Sovol3d/SOVOL-ZERO/PDF/铭牌标签说明书/0011.png

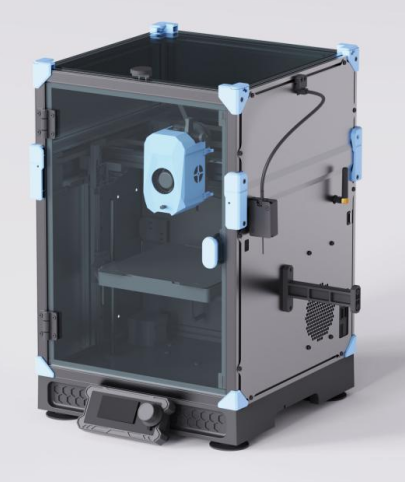
PDF/铭牌标签说明书/0011.png
