Sovol3d/SOVOL-ZERO/README.md

# Introduction

SOVOL ZERO is a fully enclosed Core-XY FDM 3D printer that ships as a complete machine. It features a build volume of 152.4x152.4x152.4mm (6x6x6 inches) and is an upgraded, large-format derivative based on the Voron V0.2 design.
It is designed to provide an alternative solution for 3D printing enthusiasts who want to use the Voron V0.2 but are hindered by its high cost and steep learning curve. We adhere to the open-source guidelines of Voron and Klipper, making SOVOL ZERO fully open-source (including hardware, firmware, and structure) for DIY enthusiasts.

Key Features of SOVOL ZERO:
Core-XY motion system design
Extremely fast operation: 1200mm/s speed and 40,000mm/s² acceleration
Generous build volume: 152.4x152.4x152.4mm (6x6x6 inches)
Stable performance: Equipped with linear guides on all axes for smooth operation
Fully assembled and pre-configured: Comes with an enclosure, ready to start printing after simple assembly
High-temperature capability: Extruder up to 350°C and bed up to 120°C, supporting a wide range of high-temp materials
Enhanced Klipper firmware details for optimized performance
No paper leveling required: Built-in inductive sensor for rapid bed leveling
Pre-installed Obico for time-lapse photography
OTA firmware updates: No need for USB drives; upgrade directly via Wi-Fi
Fully open-source design: Customize and modify to your needs
Welcome to check more on sovol3d.com

# Learn more

on Sovol Official Website: https://www.sovol3d.com/products/sovol-zero-3d-printer

# Source code

This is the official source code for SOVOL ZERO. The damage caused by modifying firmware also using the third party firmware will lose the 1 year warranty. If you need support, it’s recommended to reflash the stock firmware before contacting sovol.

Sovol doesn’t provide tech help for help users to modify source code, but if you need us to add more functions, you are welcome to send us your suggestions via Facebook Messenger or email 
info@sovol3d.com 

# Join Sovol Community

- Sovol Facebook page: https://www.facebook.com/sovol3d/
- Sovol Youtube Channel: https://www.youtube.com/c/Sovol/videos
- Sovol Offcial User Group: https://www.facebook.com/groups/sovol3d
- Sovol Forum website: https://forum.sovol3d.com/
