Sovol3d/SOVOL-ZERO/Motherboard/Extra_Pin_definition.pdf

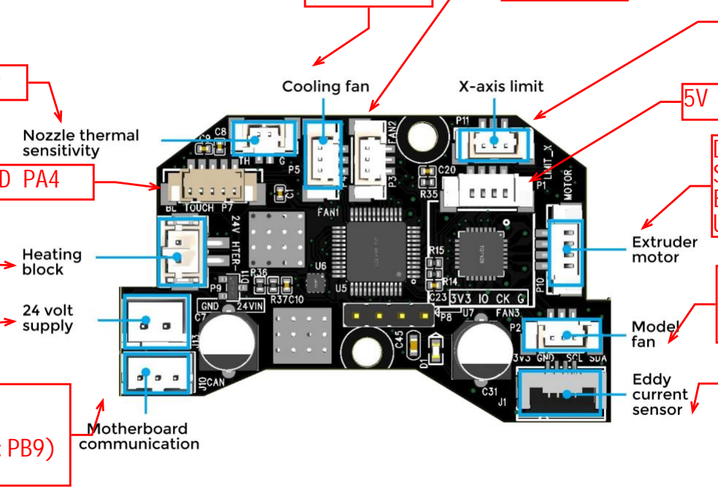
[picture p2: figure]
