Sovol3d/SOVOL-ZERO/Motherboard/Mcu_Pin_definition.pdf

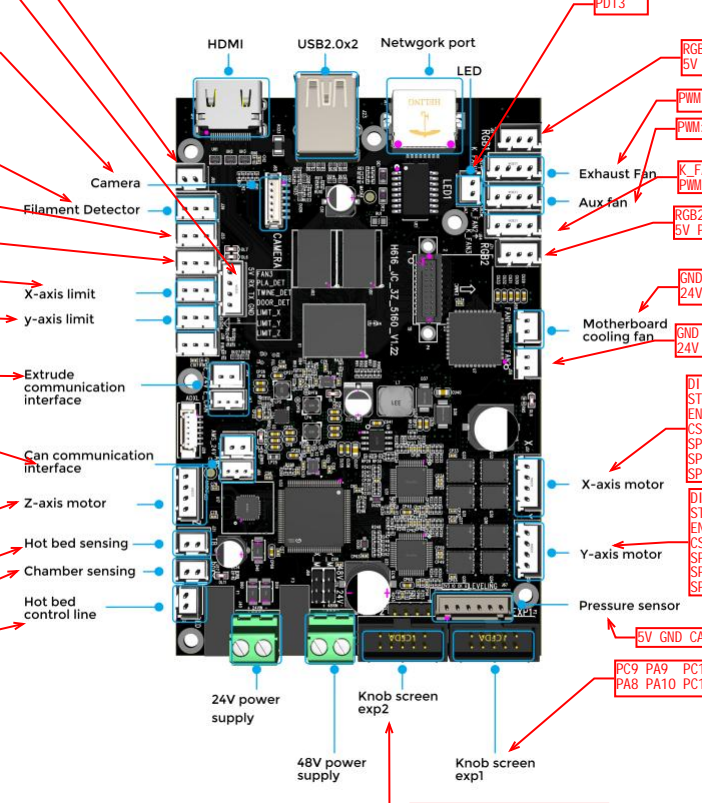
[picture p3: figure]
