Sovol3d/SOVOL-ZERO/PDF/微动开关/微动开关图纸2025.1.3.jpg

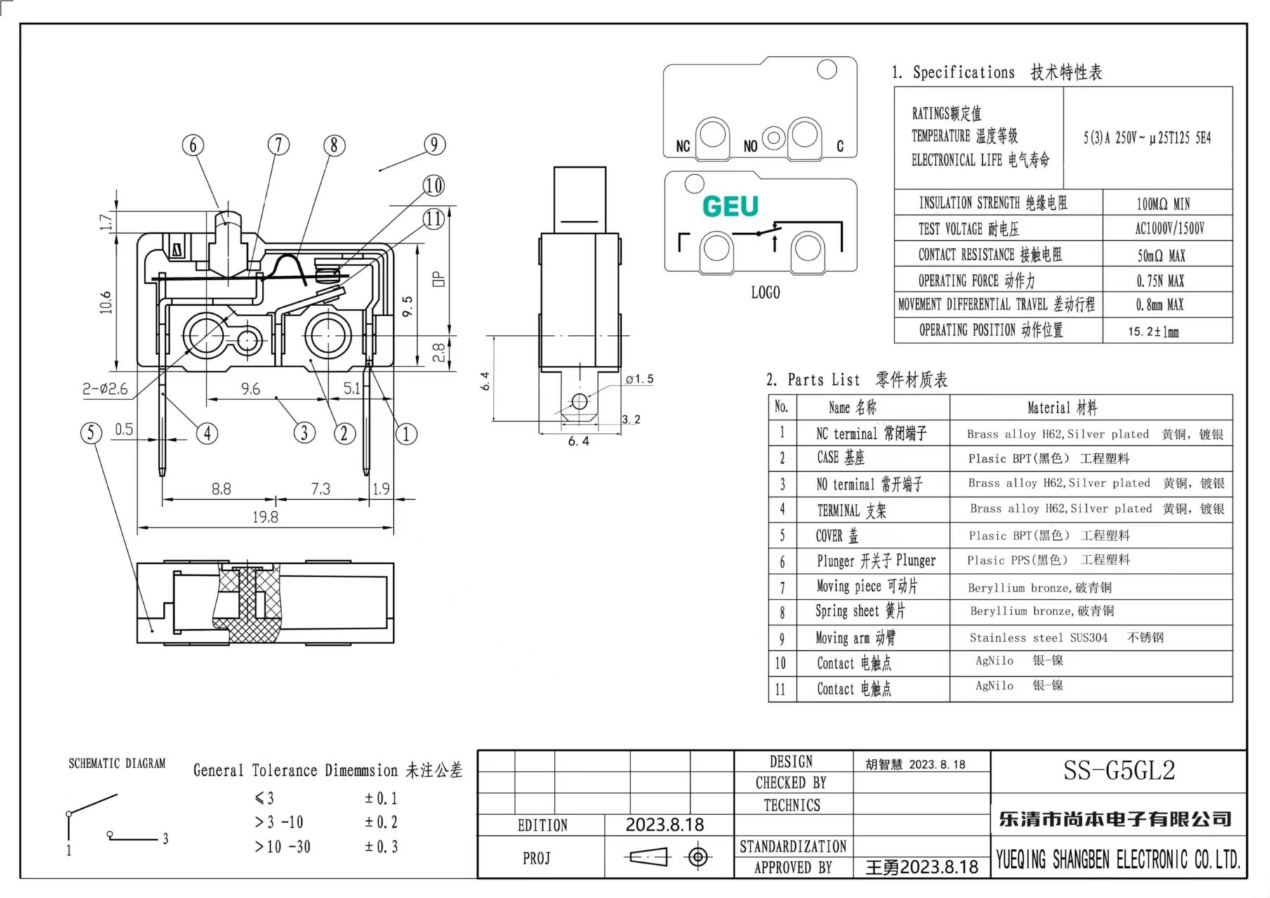
PDF/微动开关/微动开关图纸2025.1.3.jpg
