Sovol3d/SOVOL-ZERO/PDF/铭牌标签说明书/1.jpg

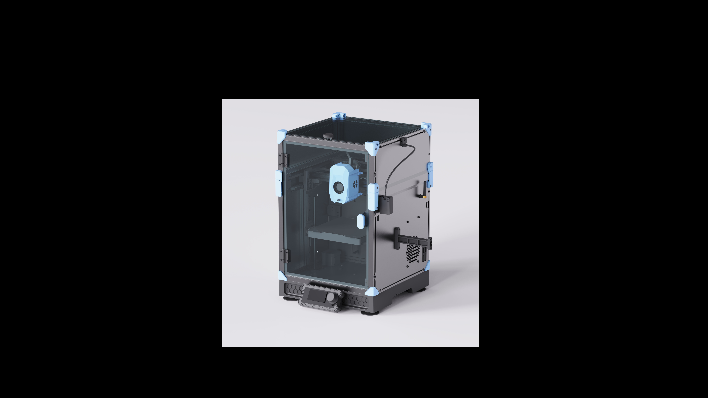
PDF/铭牌标签说明书/1.jpg
