Sovol3d/SOVOL-ZERO/PDF/PEI钢板/JXHMP4602-02014-f 打印平台钢板.step

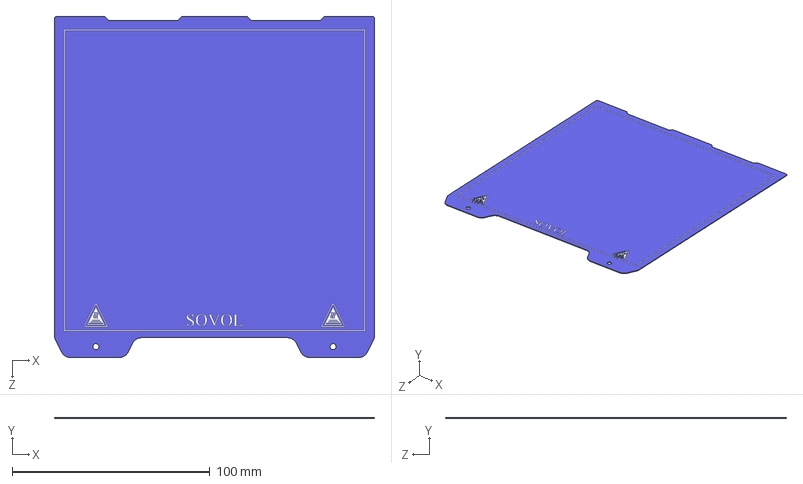
[picture p6: CAD file, 2025-03-25]
PDF/PEI钢板/JXHMP4602-02014-f 打印平台钢板.step
162.0 x 0.4 x 172.5 mm
