Sovol3d/SOVOL-ZERO/PDF/包材/泡棉/JXHMP4602-13001-h 底部泡棉.step

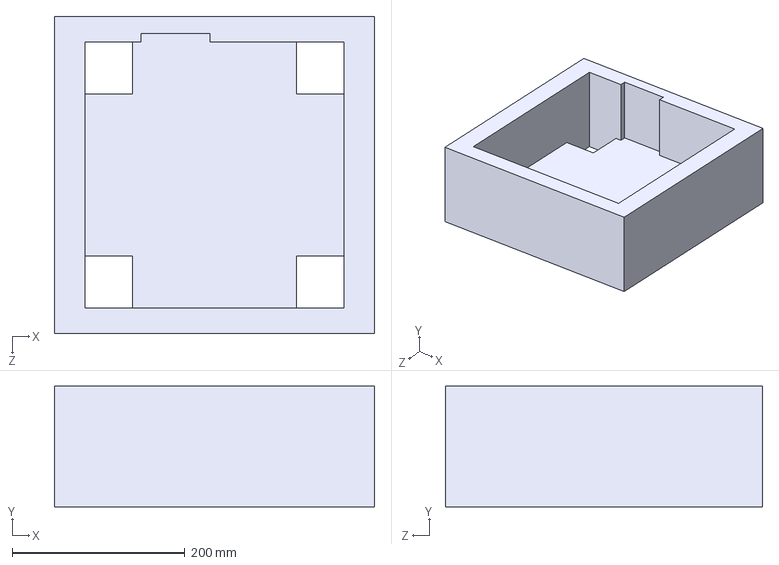
[picture p8: CAD file, 2025-03-25]
PDF/包材/泡棉/JXHMP4602-13001-h 底部泡棉.step
370.0 x 139.7 x 367.0 mm
