Sovol3d/SOVOL-ZERO/PDF/华测信/JXHMP4602-02015-f  压力传感器.step

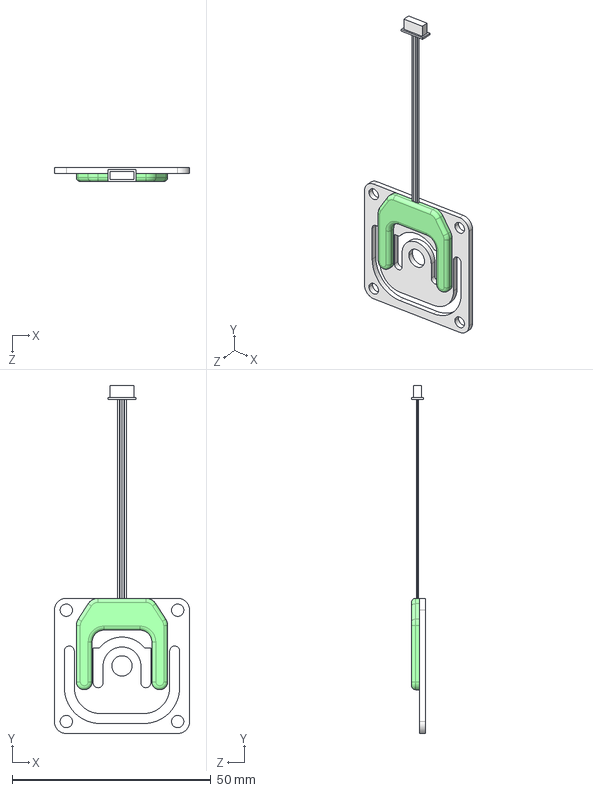
[picture p9: CAD file, 2025-03-25]
PDF/华测信/JXHMP4602-02015-f 压力传感器.step
34.0 x 87.5 x 3.50 mm
