Sovol3d/SOVOL-ZERO/PDF/开关电源盖板/JXHMP4602-04049-a 开关电源盖板.STEP

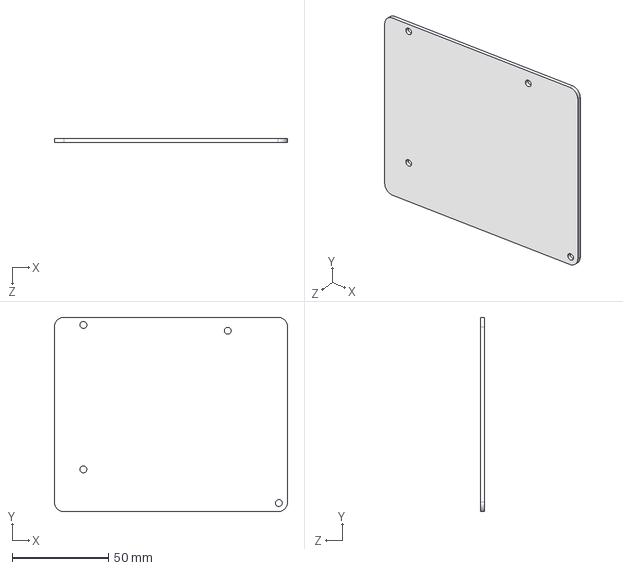
[picture p11: CAD file, 2025-03-25]
PDF/开关电源盖板/JXHMP4602-04049-a 开关电源盖板.STEP
121.0 x 101.0 x 2.00 mm
