Sovol3d/SOVOL-ZERO/PDF/电机减震垫/JXHMP4602-03091-f 电机减震垫.step

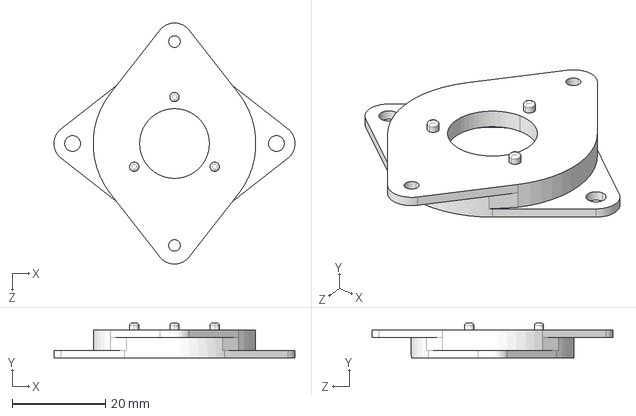
[picture p15: CAD file, 2025-03-25]
PDF/电机减震垫/JXHMP4602-03091-f 电机减震垫.step
51.8 x 7.50 x 51.8 mm
