Sovol3d/SOVOL-ZERO/PDF/硅胶套/JXHMP4602-06004-f 硅胶套.step

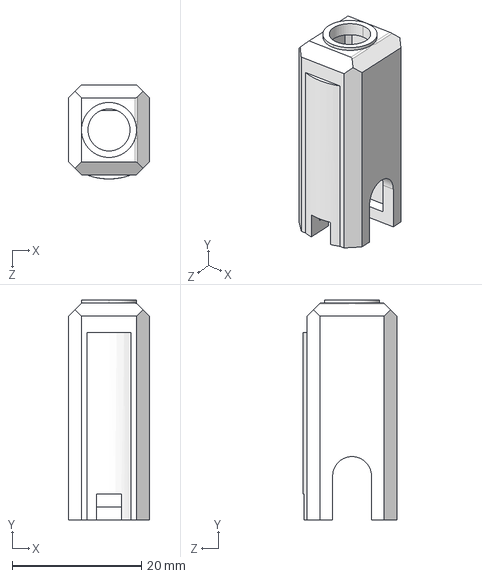
[picture p16: CAD file, 2025-03-25]
PDF/硅胶套/JXHMP4602-06004-f 硅胶套.step
12.5 x 34.0 x 14.5 mm
