Sovol3d/SOVOL-ZERO/PDF/磁铁/JXHMP4602-11081-a 磁铁.step

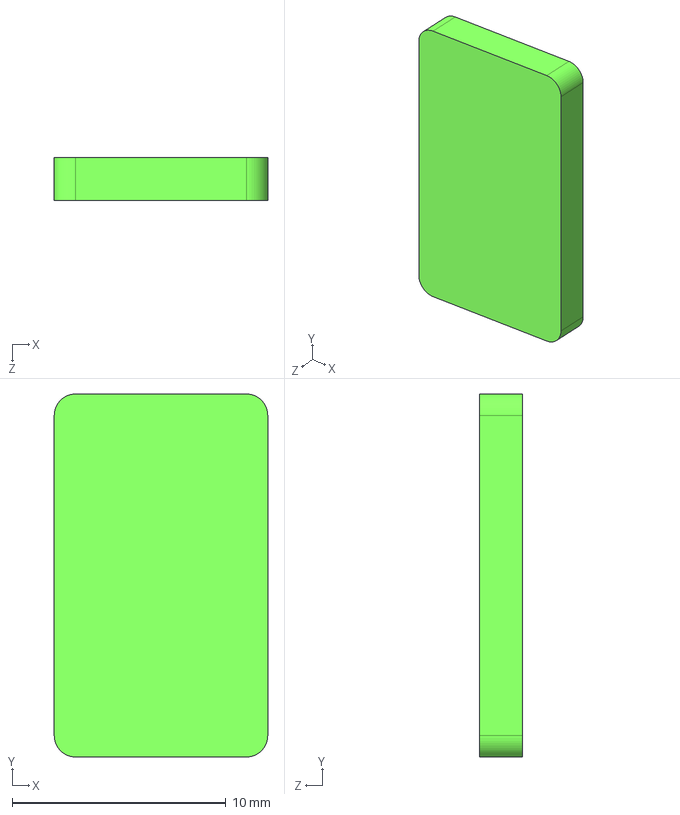
[picture p17: CAD file, 2025-03-25]
PDF/磁铁/JXHMP4602-11081-a 磁铁.step
10.0 x 17.0 x 2.00 mm
