Sovol3d/SOVOL-ZERO/PDF/线束部分/涡流FFC排线.dxf

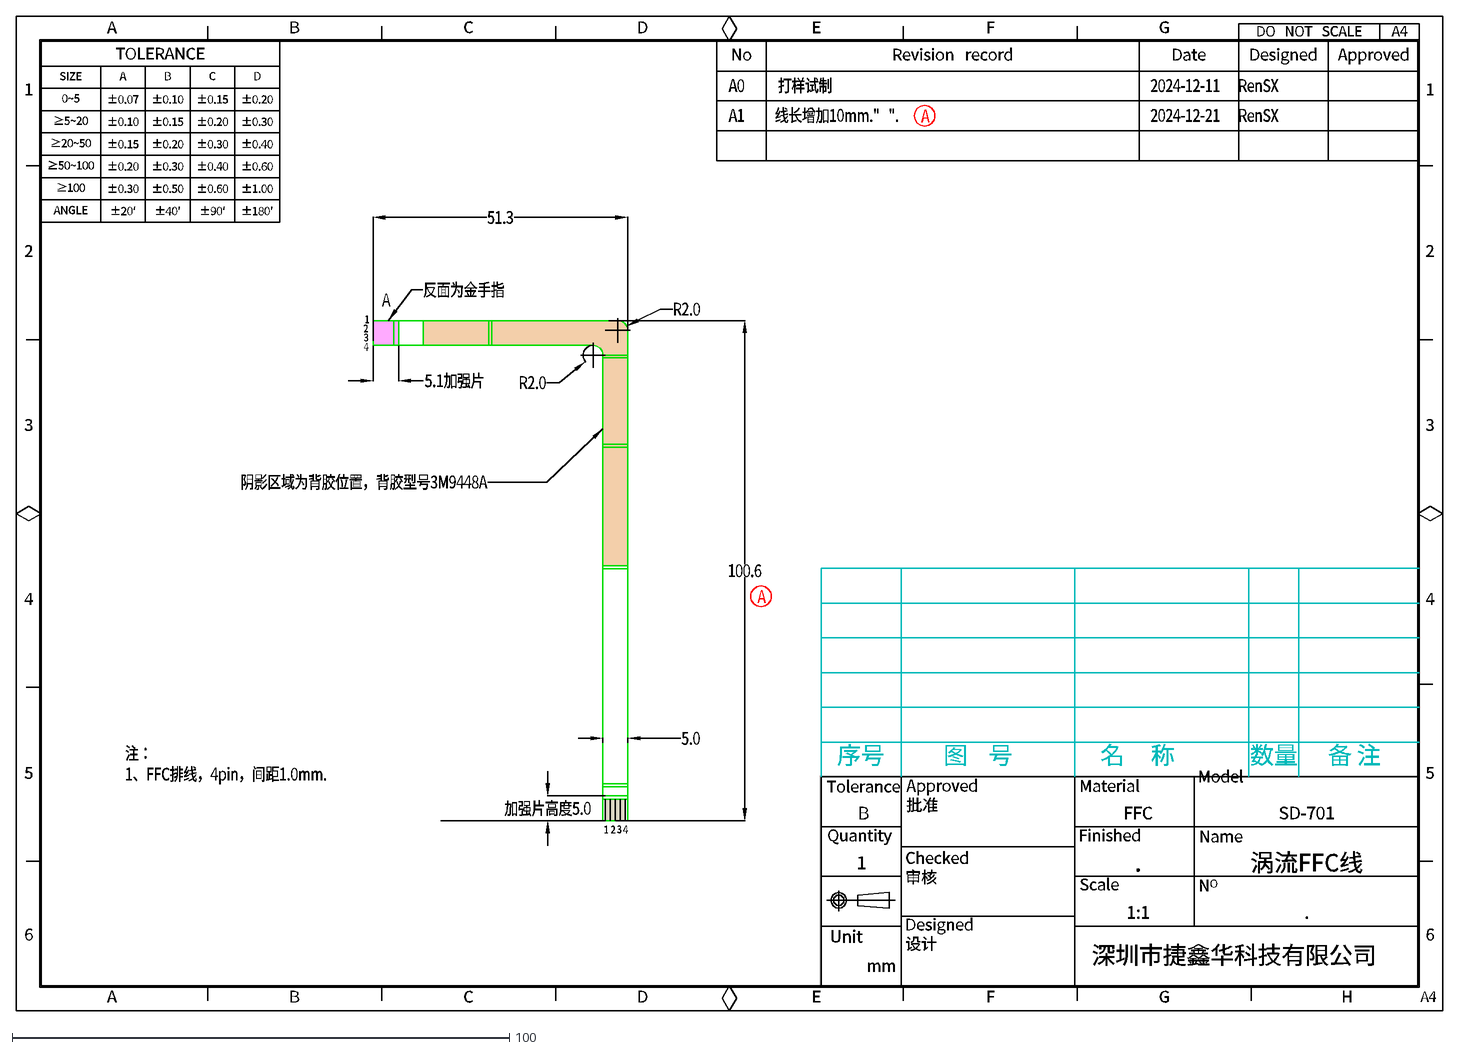
[picture p18: CAD file, 2025-03-25]
PDF/线束部分/涡流FFC排线.dxf
5.0
5.1加强片
A
1
2
3
4
反面为金手指
加强片高度5.0
SD-701
FFC
.
涡流FFC线
1:1
B
Approved
Date
Designed
Revision record
No
TOLERANCE
6
5
H
G
F
E
D
C
Tolerance
Quantity
mm
Unit
Designed 设计
Checked 审核
Scale
NO
Approved 批准
Material
Finished
Name
Model
±180′
±40′
±20′
±90′
ANGLE
≥50~100
≥100
≥20~50
0~5
SIZE
≥5~20
±0.60
±0.40
±0.30
±0.50
±0.20
±0.15
±1.00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
