Sovol3d/SOVOL-ZERO/PDF/钣金/JXHMP4602-11060-b 背面机箱封板.step

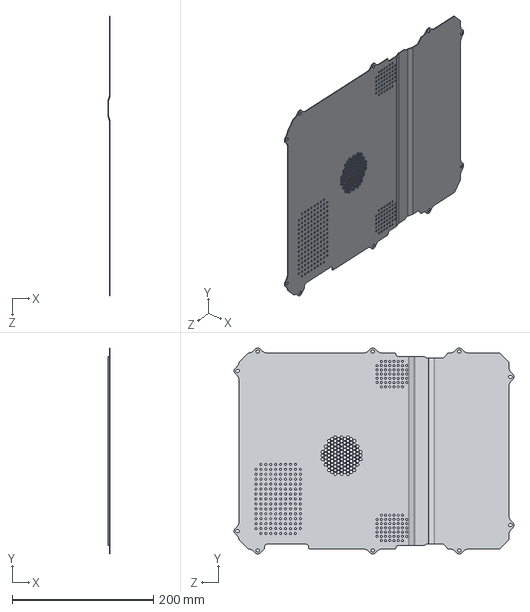
[picture p19: CAD file, 2025-03-25]
PDF/钣金/JXHMP4602-11060-b 背面机箱封板.step
3.50 x 292.0 x 396.7 mm
