Sovol3d/SOVOL-ZERO/STEP/filament runout module.step

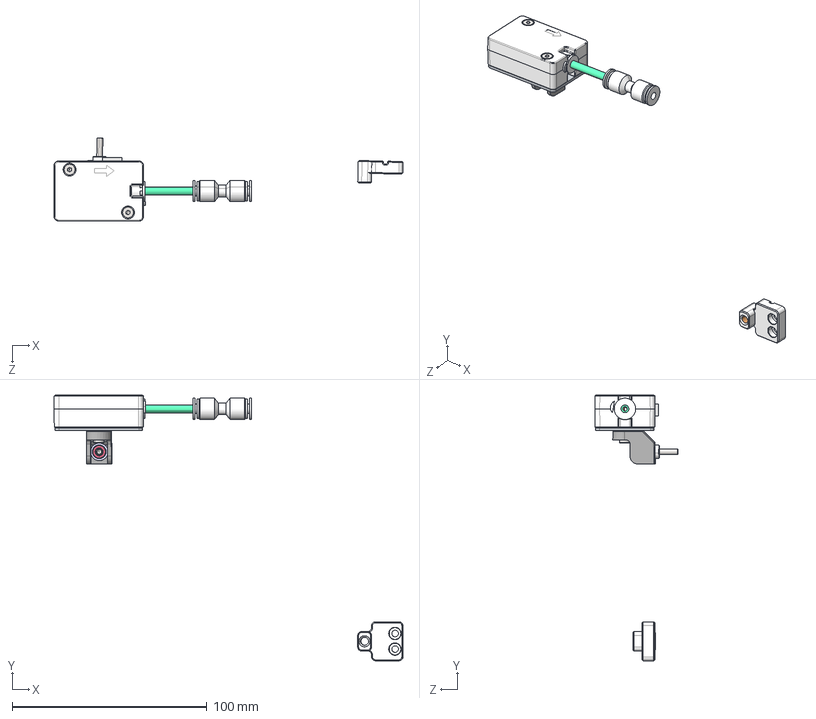
[picture p20: CAD file, 2025-03-25]
STEP/filament runout module.step
179.1 x 136.3 x 42.8 mm
JXHSV05P-07201-d 断料检测上盖 filament runout sensor top cover
JXHSV05P-07202-d 断料检测下盖 filament runout sensor below cover
JXHSV05P-07203-a 徹蹋奪1 feed tube
JXHSV05P-07204-a 徹蹋奪2 feed tube
JXHSV05P-07205-f Uﾐﾍｲﾛﾖ盖ﾐ u-groove bearing
JXHSV05P-07206-d 限位开关挡块 limit switch stop block
JXHSV05P-07208-a 粣 a-axis
JXHSV05P-07209-a 粣杶 axle sleeve
JXHSV05P-07210-h 断料检测PCB filament runout sensor pcb
JXHSV06P-07009-a 啊裝路燭翐 swing rod isolation column x 2
JXHSV05P-07214-b 嘐隅啣 fixed plate
线径0.3外径4长度10弹簧 断料检测弹簧 filament runout sensor spring
固定4mm铁氟龙管 快插接头管卡 tpfe tube quick plug adapter tube
固定4MM铁氟龙管 快接头 tpfe tube quick coupling
铁氟龙管 ptfe tube
GB-T-70.1-2000-M2X5 内六角圆柱头螺丝 hex socket cylindrical head screws x 2
GB-T-70.3-2000-M3x18 内六角沉头螺丝 hexagon socket countersunk head screw x 2
JXHSV06P-07008-d 断料检测摆杆 filament runout sensor oscillating bar
GB-T-70.1-2000-M3x8 内六角圆柱头螺丝 hex socket cylindrical head screws
A级大平垫GB-T96.1-2022-3 平垫圈 flat washer
GB-T-70.1-2000-M3x16 内六角圆柱头螺丝 hexagon socket countersunk head screw
ァ雄諉芛 pneumatic joint
JXHSV05P-07213-d 铁氟龙管支撑架 ptfe tube support frame
JXHMP4602-02018-d 路燭翐 insulated column
