Sovol3d/SOVOL-ZERO/PDF/包材/泡棉/JXHMP4602-13004-h 限位泡棉.STEP

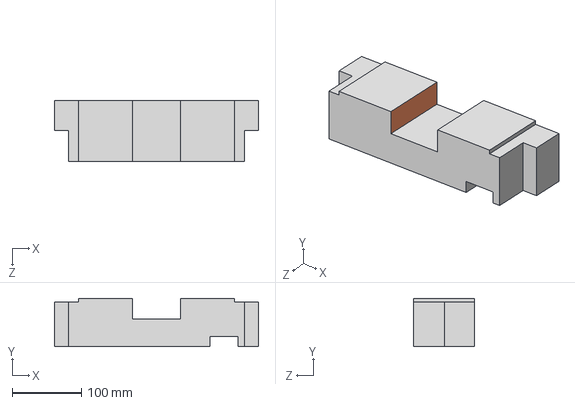
[picture p21: CAD file, 2025-03-25]
PDF/包材/泡棉/JXHMP4602-13004-h 限位泡棉.STEP
295.0 x 70.0 x 88.0 mm
