Sovol3d/SOVOL-ZERO/PDF/型材/JXHMP4602-03090-a 前右立柱.step

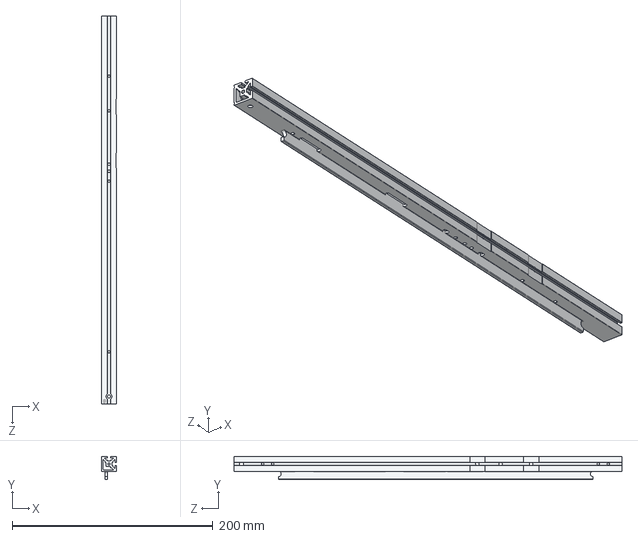
[picture p22: CAD file, 2025-03-25]
PDF/型材/JXHMP4602-03090-a 前右立柱.step
15.0 x 23.0 x 386.8 mm
