Sovol3d/SOVOL-ZERO/STEP/filament holder kit.step

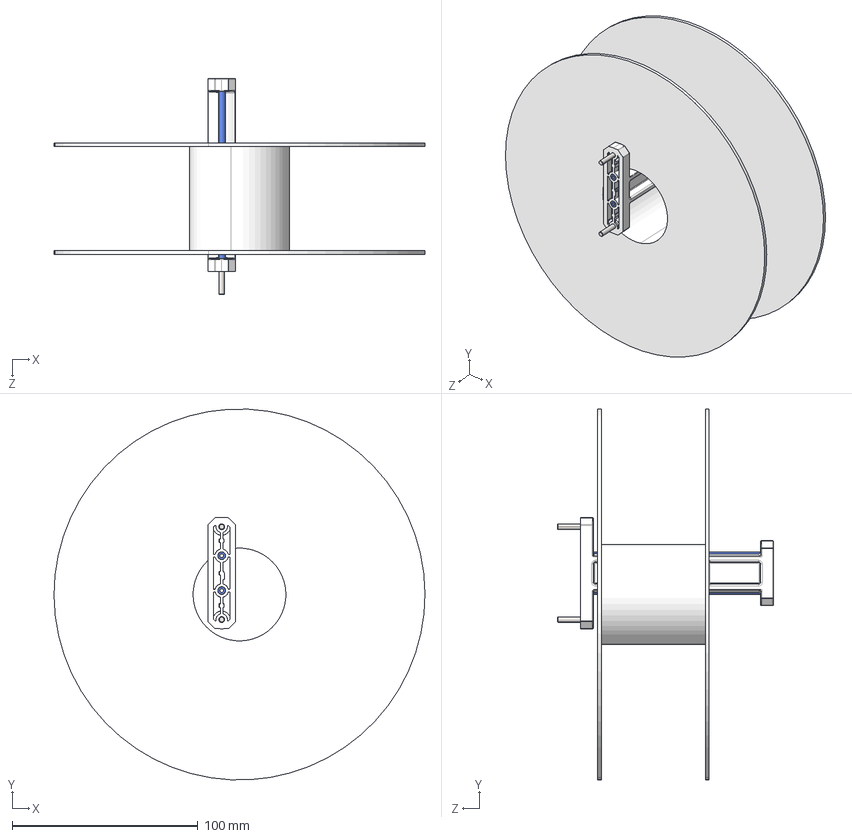
[picture p27: CAD file, 2025-03-25]
STEP/filament holder kit.step
200.0 x 199.8 x 116.4 mm
1KG瘧第 filament
JXHMP4602-10001-d 蹋殤 filament holder
外径4mm,内径2mm长度xxmm 铁氟龙管 ptfe tube x 2
GB-T-70.1-2000-M3x16 内六角圆柱头螺丝 hexagon socket countersunk head screw x 2
