Sovol3d/SOVOL-ZERO/PDF/包材/泡棉/JXHMP4602-13003-h 平盖棉.step

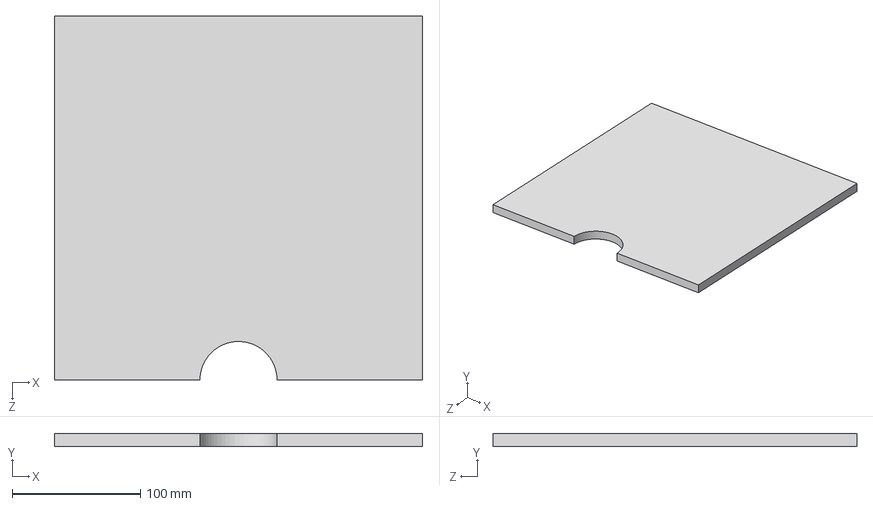
[picture p28: CAD file, 2025-03-25]
PDF/包材/泡棉/JXHMP4602-13003-h 平盖棉.step
287.0 x 10.0 x 283.5 mm
