Sovol3d/SOVOL-ZERO/PDF/型材/JXHMP4602-03023-a 底后横梁.step

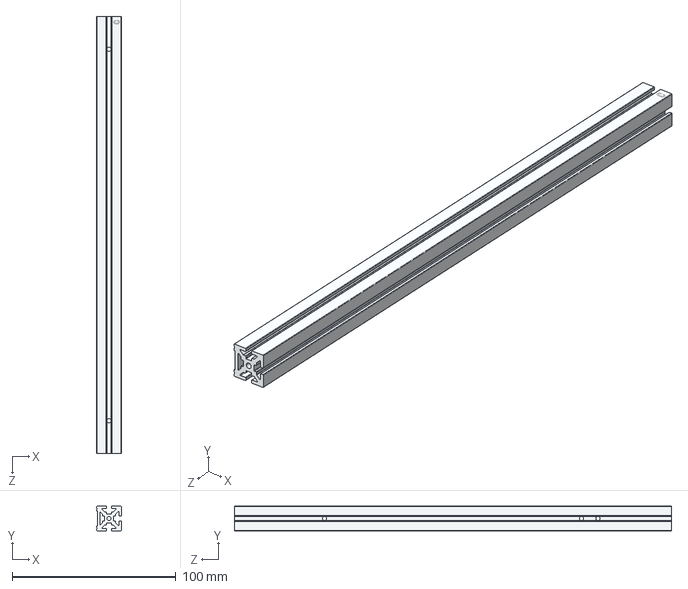
[picture p29: CAD file, 2025-03-25]
PDF/型材/JXHMP4602-03023-a 底后横梁.step
15.0 x 15.0 x 267.0 mm
