Sovol3d/SOVOL-ZERO/PDF/机加/JXHMP4602-08054-a 硬化喷嘴.STEP

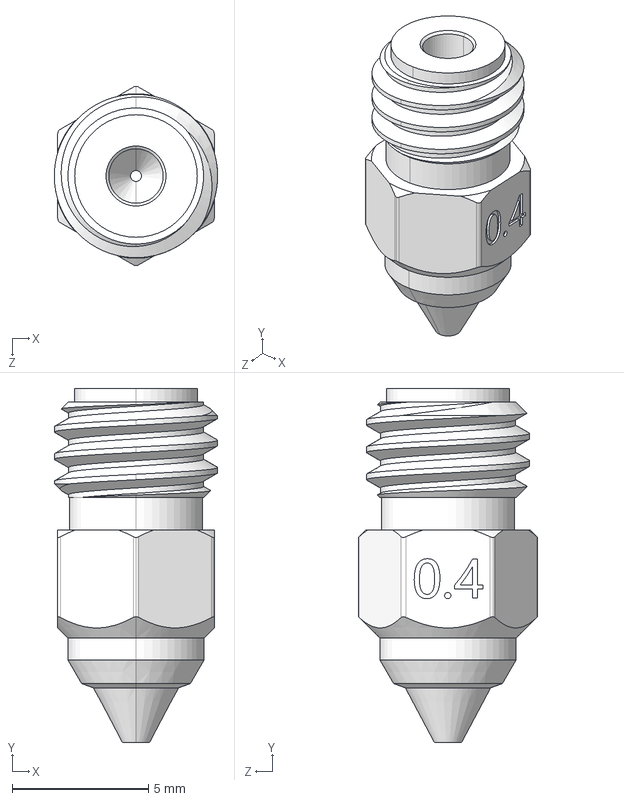
[picture p30: CAD file, 2025-03-25]
PDF/机加/JXHMP4602-08054-a 硬化喷嘴.STEP
6.00 x 13.0 x 6.58 mm
