Sovol3d/SOVOL-ZERO/PDF/滑轨/MGN9H1R197Z0 直线滑轨.step

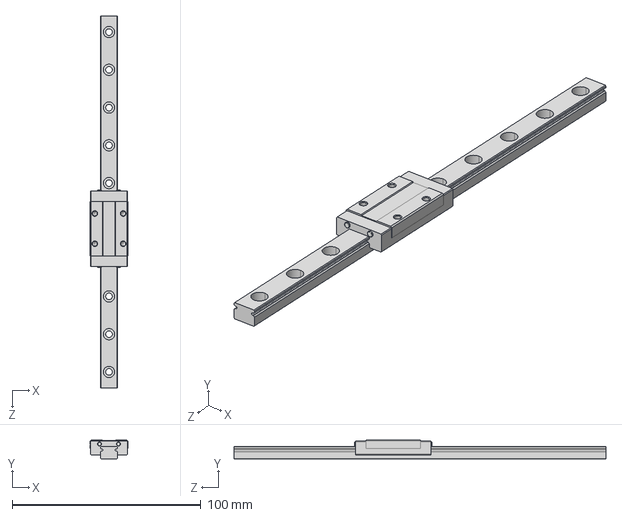
[picture p31: CAD file, 2025-03-25]
PDF/滑轨/MGN9H1R197Z0 直线滑轨.step
20.0 x 10.0 x 197.0 mm
MGNR9R197C 賑寢
MGN9HZ1C 賑輸
