Sovol3d/SOVOL-ZERO/PDF/钣金/JXHMP4602-01004-b 底座惰轮调整板.STEP

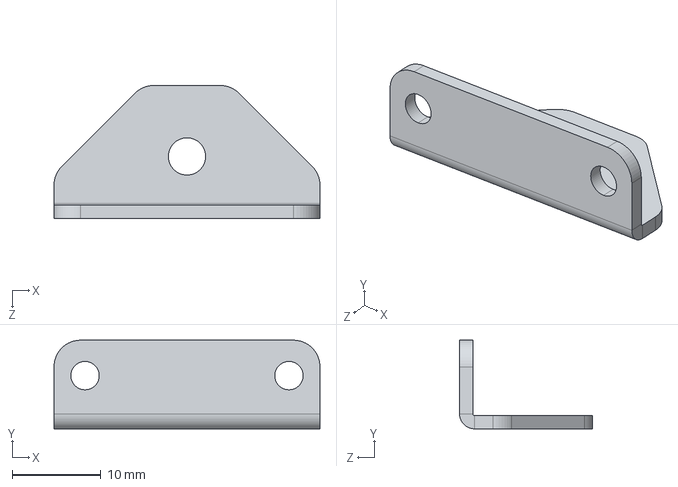
[picture p32: CAD file, 2025-03-25]
PDF/钣金/JXHMP4602-01004-b 底座惰轮调整板.STEP
30.0 x 10.0 x 15.0 mm
