Sovol3d/SOVOL-ZERO/STEP/camera module.step

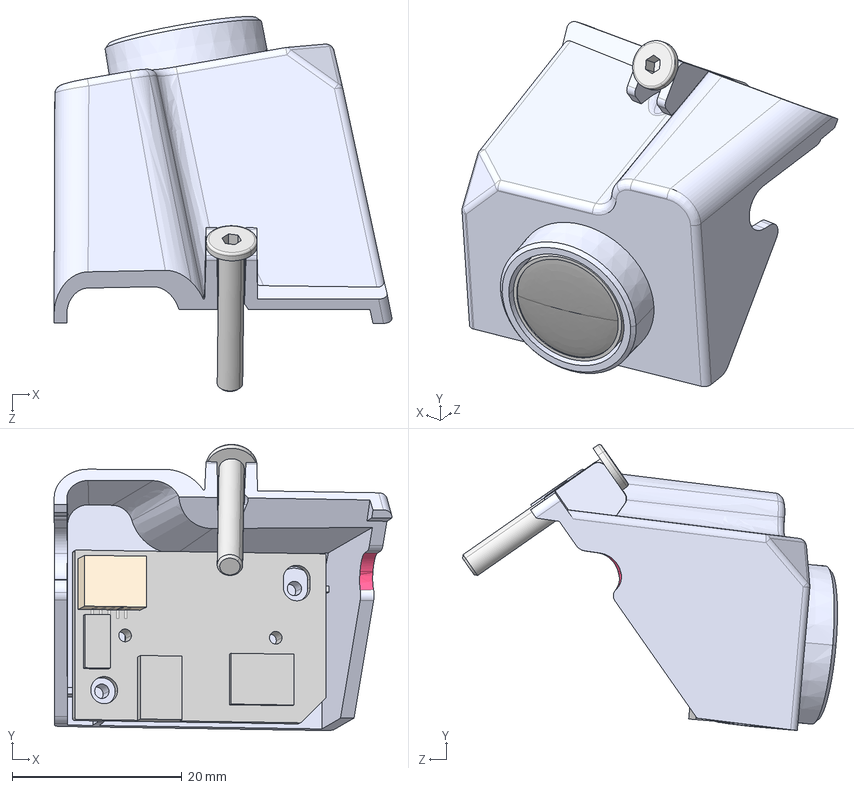
[picture p33: CAD file, 2025-03-25]
STEP/camera module.step
39.8 x 33.7 x 44.1 mm
JXHMP4602-09081-d 摄像头盖板 camera cover plate
160度广角100W像素 摄像头模组 wide angle camera module
M3X20 ｱ簇ｽﾍｷﾂﾝﾋｿ fat offset head screws
