Sovol3d/SOVOL-ZERO/PDF/包材/泡棉/JXHMP4602-13009-h 填充泡棉1.step

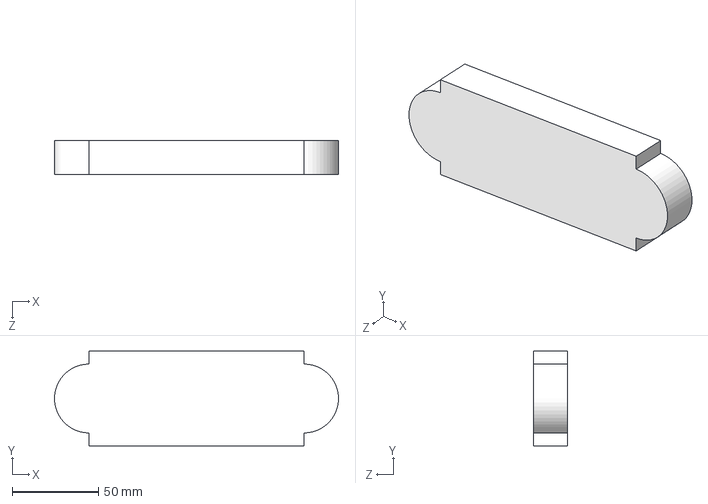
[picture p34: CAD file, 2025-03-25]
PDF/包材/泡棉/JXHMP4602-13009-h 填充泡棉1.step
165.0 x 55.0 x 20.0 mm
