Sovol3d/SOVOL-ZERO/PDF/型材/JXHMP4602-03040-a 顶前型材.step

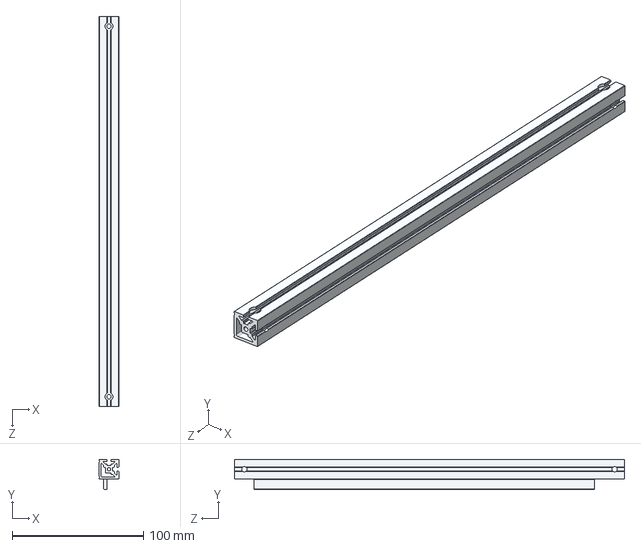
[picture p35: CAD file, 2025-03-25]
PDF/型材/JXHMP4602-03040-a 顶前型材.step
15.0 x 23.0 x 297.0 mm
