Sovol3d/SOVOL-ZERO/PDF/钣金/JXHMP4602-01008-b 底座封板.step

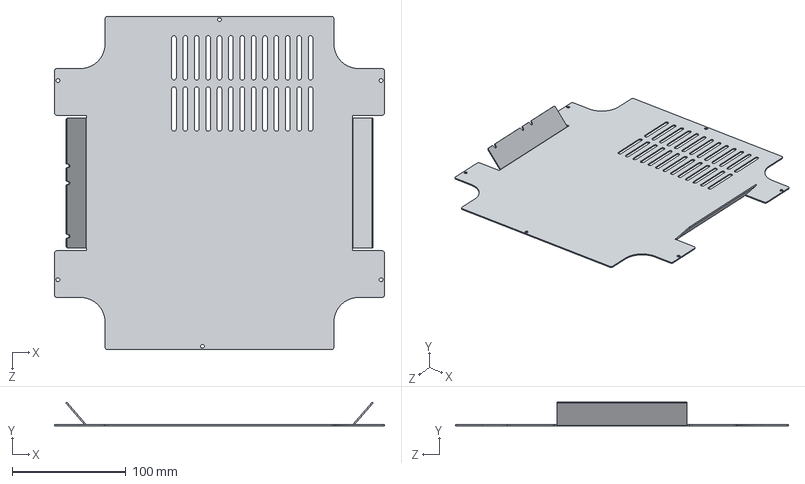
[picture p37: CAD file, 2025-03-25]
PDF/钣金/JXHMP4602-01008-b 底座封板.step
290.0 x 20.8 x 293.0 mm
