Sovol3d/SOVOL-ZERO/PDF/包材/泡棉/JXHMP4602-13002-h 顶部泡棉.step

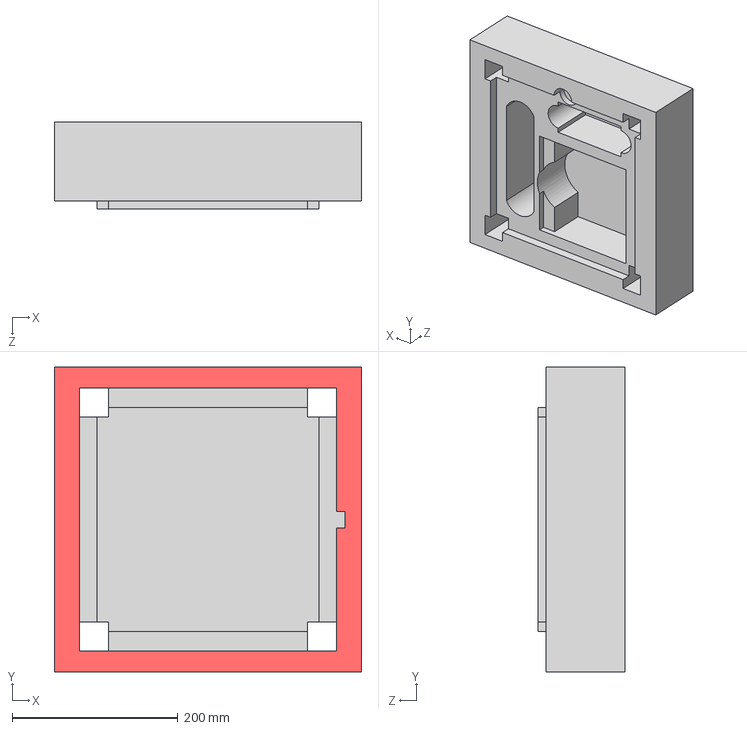
[picture p38: CAD file, 2025-03-25]
PDF/包材/泡棉/JXHMP4602-13002-h 顶部泡棉.step
370.0 x 367.0 x 105.0 mm
