Sovol3d/SOVOL-ZERO/PDF/机加/JXHMP4062-08048-a 加热块.step

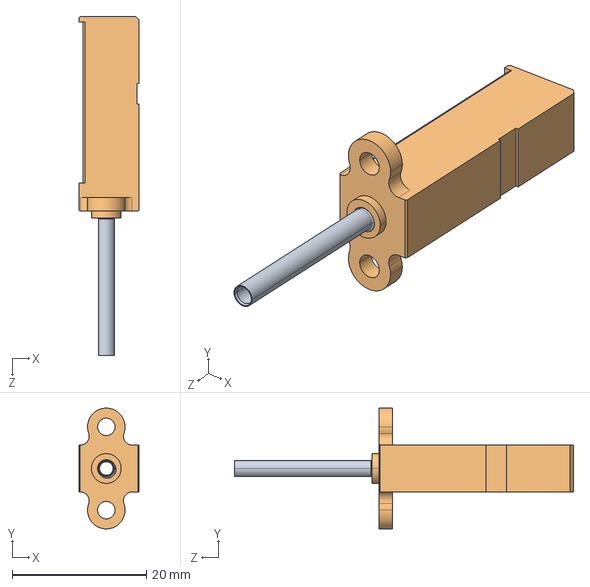
[picture p40: CAD file, 2025-03-25]
PDF/机加/JXHMP4062-08048-a 加热块.step
9.00 x 18.0 x 50.5 mm
