Sovol3d/SOVOL-ZERO/PDF/包材/泡棉/JXHMP4602-13008-h 限位块.STEP

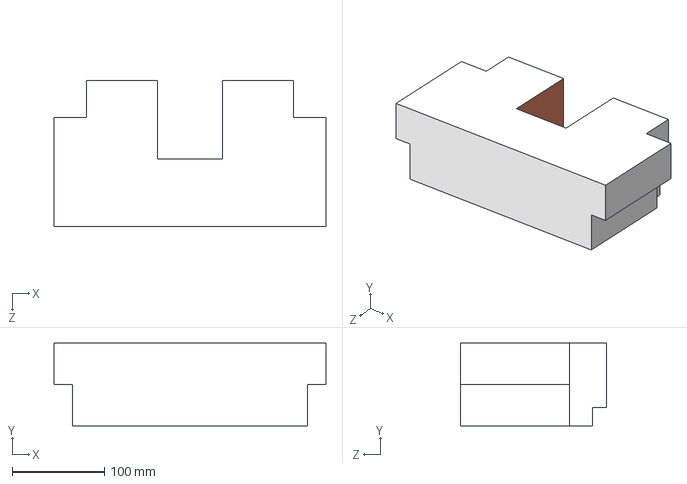
[picture p42: CAD file, 2025-03-25]
PDF/包材/泡棉/JXHMP4602-13008-h 限位块.STEP
295.0 x 90.0 x 158.0 mm
