Sovol3d/SOVOL-ZERO/PDF/型材/JXHMP4602-03019-a 后下立柱.step

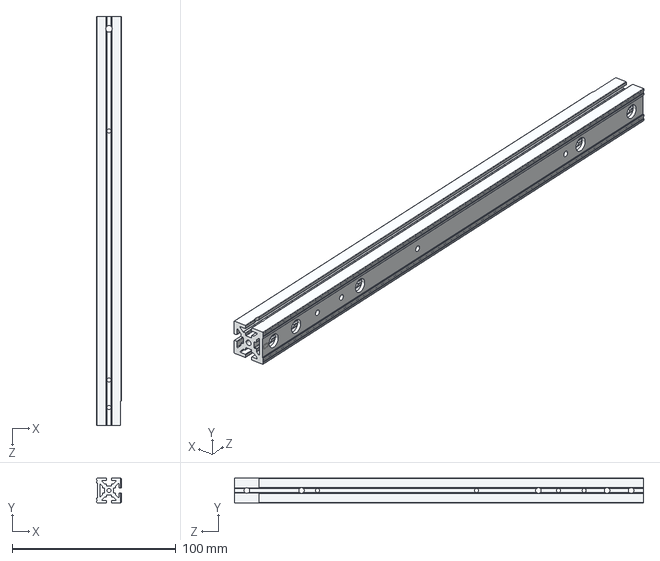
[picture p43: CAD file, 2025-03-25]
PDF/型材/JXHMP4602-03019-a 后下立柱.step
15.0 x 15.0 x 250.0 mm
