Sovol3d/SOVOL-ZERO/PDF/包材/泡棉/JXHMP4602-13010-h 填充泡棉2.step

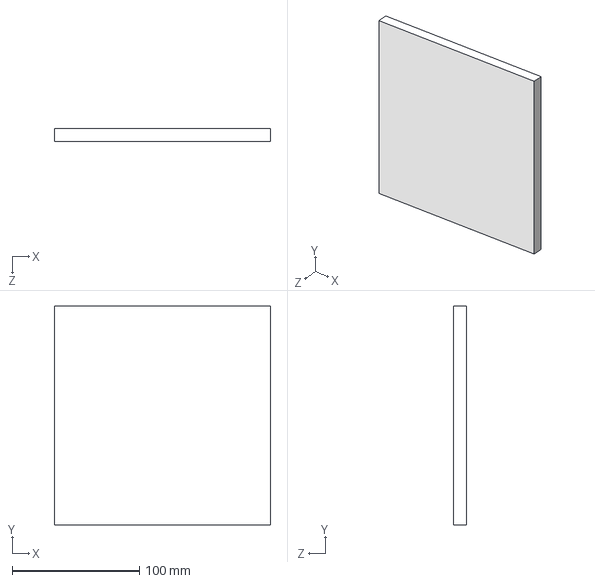
[picture p44: CAD file, 2025-03-25]
PDF/包材/泡棉/JXHMP4602-13010-h 填充泡棉2.step
170.0 x 172.0 x 10.0 mm
