Sovol3d/SOVOL-ZERO/PDF/包材/泡棉/JXHMP4602-13011-h 填充泡棉3.step

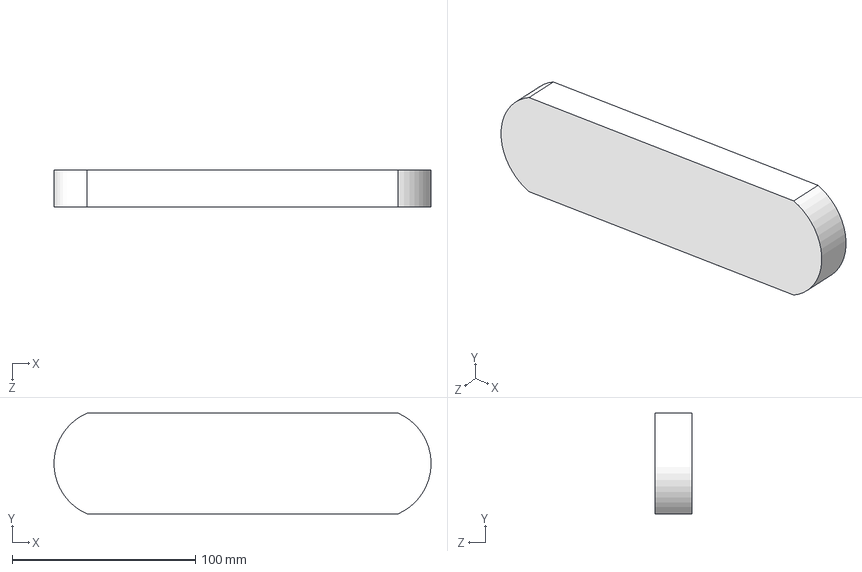
[picture p46: CAD file, 2025-03-25]
PDF/包材/泡棉/JXHMP4602-13011-h 填充泡棉3.step
206.0 x 55.0 x 20.0 mm
