Sovol3d/SOVOL-ZERO/PDF/机加/JXHMP4602-12022-a 喷头板散热片.STEP

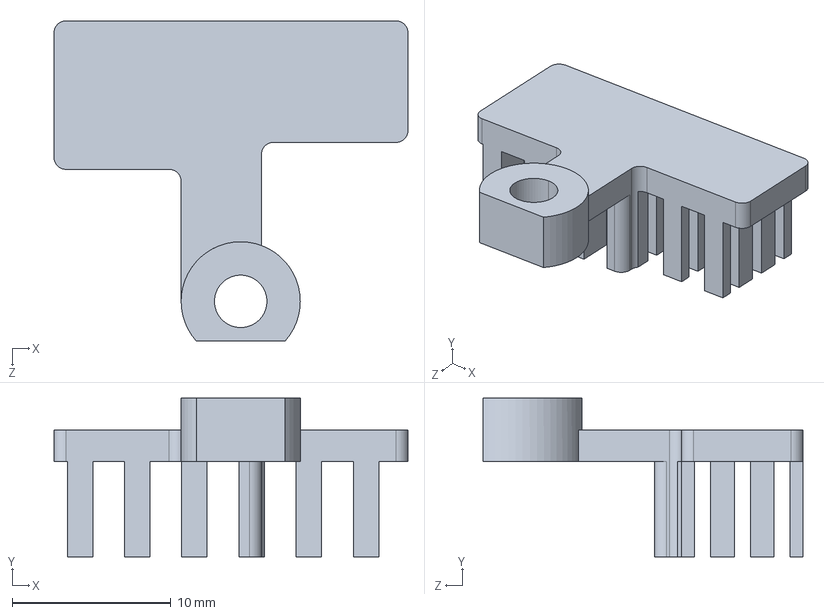
[picture p47: CAD file, 2025-03-25]
PDF/机加/JXHMP4602-12022-a 喷头板散热片.STEP
22.3 x 10.0 x 20.1 mm
