Sovol3d/SOVOL-ZERO/PDF/钣金/JXHMP4602-02009-b 热床支撑板.STEP

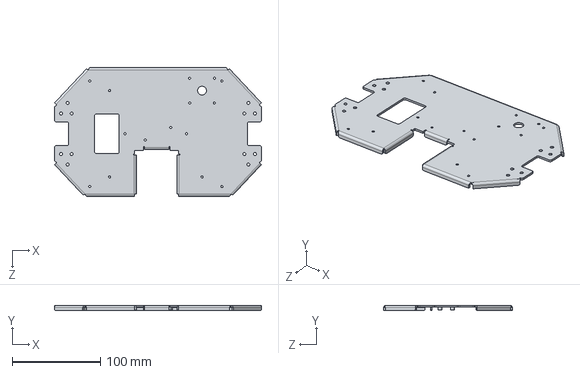
[picture p48: CAD file, 2025-03-25]
PDF/钣金/JXHMP4602-02009-b 热床支撑板.STEP
235.0 x 6.00 x 146.0 mm
