Sovol3d/SOVOL-ZERO/PDF/型材/JXHMP4602-05048-a X轴横梁.step

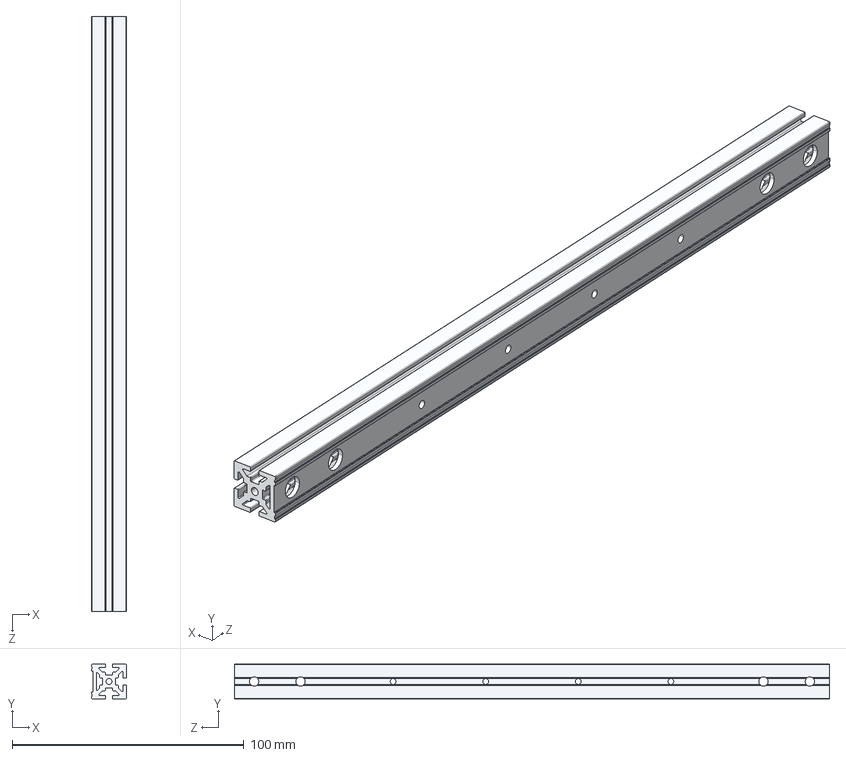
[picture p49: CAD file, 2025-03-25]
PDF/型材/JXHMP4602-05048-a X轴横梁.step
15.0 x 15.0 x 257.0 mm
