Sovol3d/SOVOL-ZERO/PDF/型材/JXHMP4602-03041-a 顶后型材.step

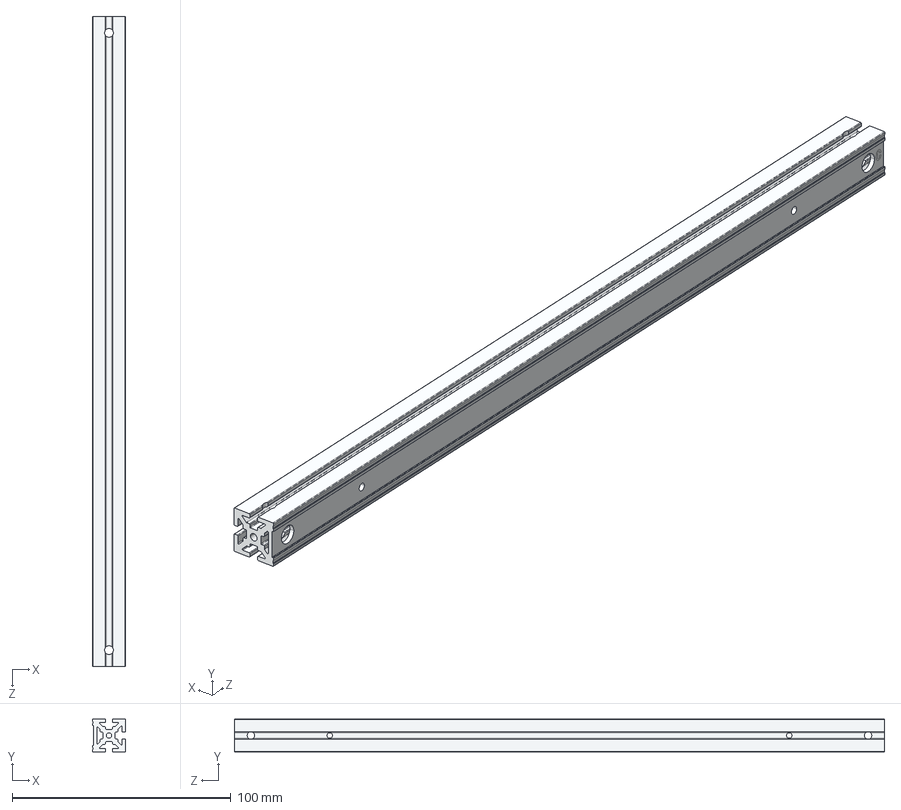
[picture p50: CAD file, 2025-03-25]
PDF/型材/JXHMP4602-03041-a 顶后型材.step
15.0 x 15.0 x 297.0 mm
