Sovol3d/SOVOL-ZERO/PDF/型材/JXHMP4602-03039-a 顶上立柱.step

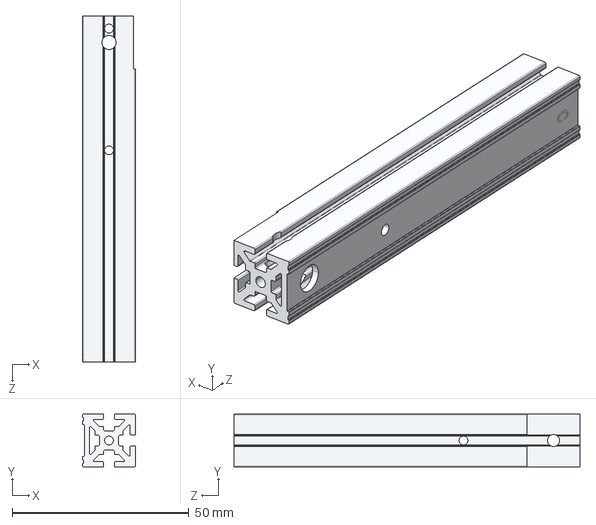
[picture p52: CAD file, 2025-03-25]
PDF/型材/JXHMP4602-03039-a 顶上立柱.step
15.0 x 15.0 x 98.0 mm
