Sovol3d/SOVOL-ZERO/PDF/型材/JXHMP4602-03032-a 后中横梁.step

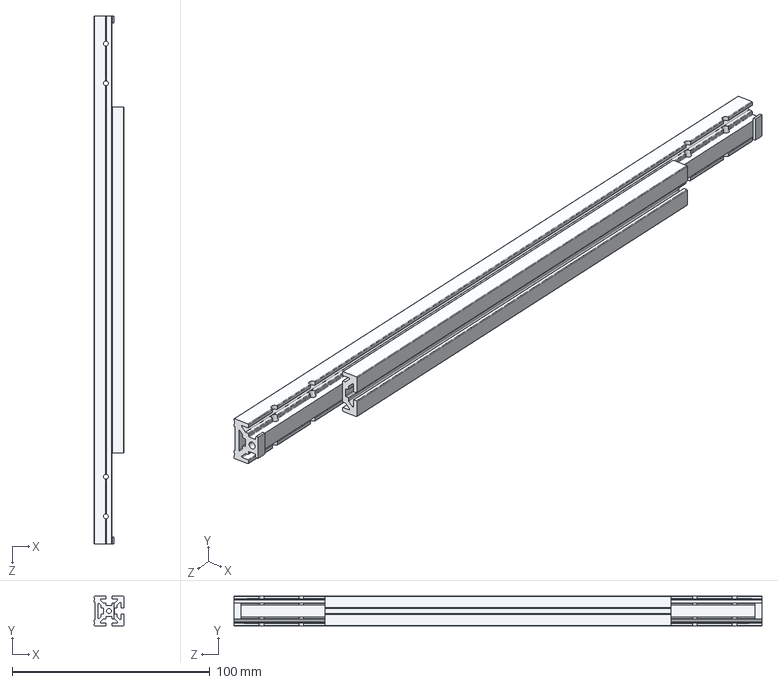
[picture p53: CAD file, 2025-03-25]
PDF/型材/JXHMP4602-03032-a 后中横梁.step
15.0 x 15.0 x 267.0 mm
