Sovol3d/SOVOL-ZERO/PDF/型材/JXHMP4602-03021-a 前左立柱.step

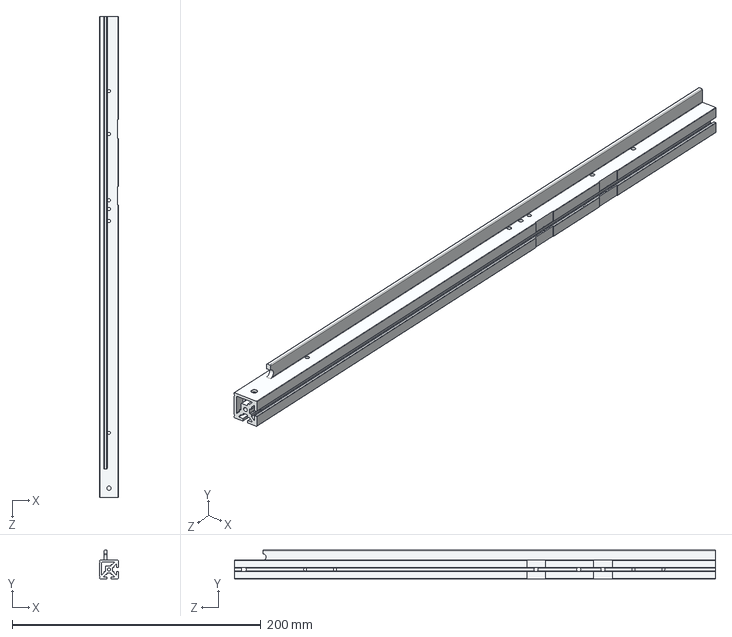
[picture p54: CAD file, 2025-03-25]
PDF/型材/JXHMP4602-03021-a 前左立柱.step
15.0 x 23.0 x 386.8 mm
