Sovol3d/SOVOL-ZERO/(list of files, cad)

Other CAD files:
PDF/活性炭过滤盒/JXHMP4602-06056-d 活性炭过滤耗材盒.DWG
PDF/温度传感器 PT1000B/JXHMP4602-08052-f 温度传感器 PT1000B.dwg
PDF/热床/JXHMP4602-02008-f 热床板.DWG
PDF/热敏/JXHMP4602-08052-f 温度传感器 PT1000B.dwg
PDF/线束部分/过热保护/MP4602(1).dwg
PDF/软磁贴/JXHMP4602-02013-f 软磁板.DWG
PDF/阻尼合页/CL2420 阻尼合页.DWG
PDF/陶瓷加热/JXHMP4602-08053-f 陶瓷加热片.DWG
PDF/磁铁/JXHMP4602-02013-f 软磁板.DWG
PDF/线束部分/MP4602.dwg
PDF/机加/JXHMP4602-08050-a 黄铜喷嘴.step
PDF/钣金/JXHMP4602-11059-b 外壳封板2.DWG
PDF/型材/JXHMP4602-03031-a 顶部加强型材.step
PDF/钣金/JXHMP4602-11058-b 外壳封板1.step
PDF/型材/JXHMP4602-03091-a 顶部加强型材-右.step
PDF/型材/JXHMP4602-03022-a 底部纵梁.step
PDF/型材/JXHMP4602-03018-a 左上横梁.step
PDF/型材/JXHMP4602-03034-a 后上横梁.step
PDF/型材/JXHMP4602-03092-a 底部左纵梁.step
PDF/PEI钢板/JXHMP4602-02014-f 打印平台钢板.DWG
PDF/丝杠/JXHMP4602-01007-a Z轴丝杆.dwg
PDF/包材/泡棉/JXHMP4602-13001-h 底部泡棉.dwg
PDF/包材/泡棉/JXHMP4602-13002-h 顶部泡棉.dwg
PDF/包材/泡棉/JXHMP4602-13003-h 平盖棉.dwg
PDF/包材/泡棉/JXHMP4602-13009-h 填充泡棉1.dwg
PDF/包材/泡棉/JXHMP4602-13010-h 填充泡棉2.dwg
PDF/包材/泡棉/JXHMP4602-13011-h 填充泡棉3.dwg
PDF/华测信/JXHMP4602-02015-f 压力传感器.DWG
PDF/开关电源盖板/JXHMP4602-04049-a 开关电源盖板.DWG
PDF/机加/JXHMP4062-08048-a 加热块.DWG
PDF/机加/JXHMP4062-08048-a 加热块.SLDDRW
PDF/机加/JXHMP4602-01009-a 隔离柱.dwg
PDF/机加/JXHMP4602-01010-a 惰轮轴.dwg
PDF/机加/JXHMP4602-03027-a 毛细管1.dwg
PDF/机加/JXHMP4602-03057-a 惰轮隔离件.dwg
PDF/滑轨/MGN9H1R197Z0 直线滑轨.dwg
PDF/滑轨/MGN9H1R211Z0 直线滑轨.dwg
PDF/滑轨/MGN9H1R256Z0 直线滑轨-X.dwg
PDF/玻璃/JXHMP4602-11062-f 顶盖板.dwg
PDF/玻璃/JXHMP4602-11063-f 前门.DWG
PDF/电机减震垫/JXHMP4602-03091-f 电机减震垫.dwg
PDF/线束部分/涡流排线/200599101143(S216137A)单件图.dwg
PDF/钣金/JXHMP4602-01004-b 底座惰轮调整板.DWG
PDF/钣金/JXHMP4602-01005-b 底部安装板.dwg
PDF/钣金/JXHMP4602-01008-b 底座封板.dwg
PDF/钣金/JXHMP4602-02009-b 热床支撑板.DWG
PDF/钣金/JXHMP4602-08051-b 喷头滑动板.dwg
PDF/钣金/JXHMP4602-11058-b 外壳封板1.dwg
PDF/钣金/JXHMP4602-11060-b 背面机箱封板.dwg
PDF/钣金/JXHMP4602-11083-b 铁片.dwg
