Sovol3d/SOVOL-ZERO/PDF/型材/JXHMP4602-03090-a 前右立柱.pdf

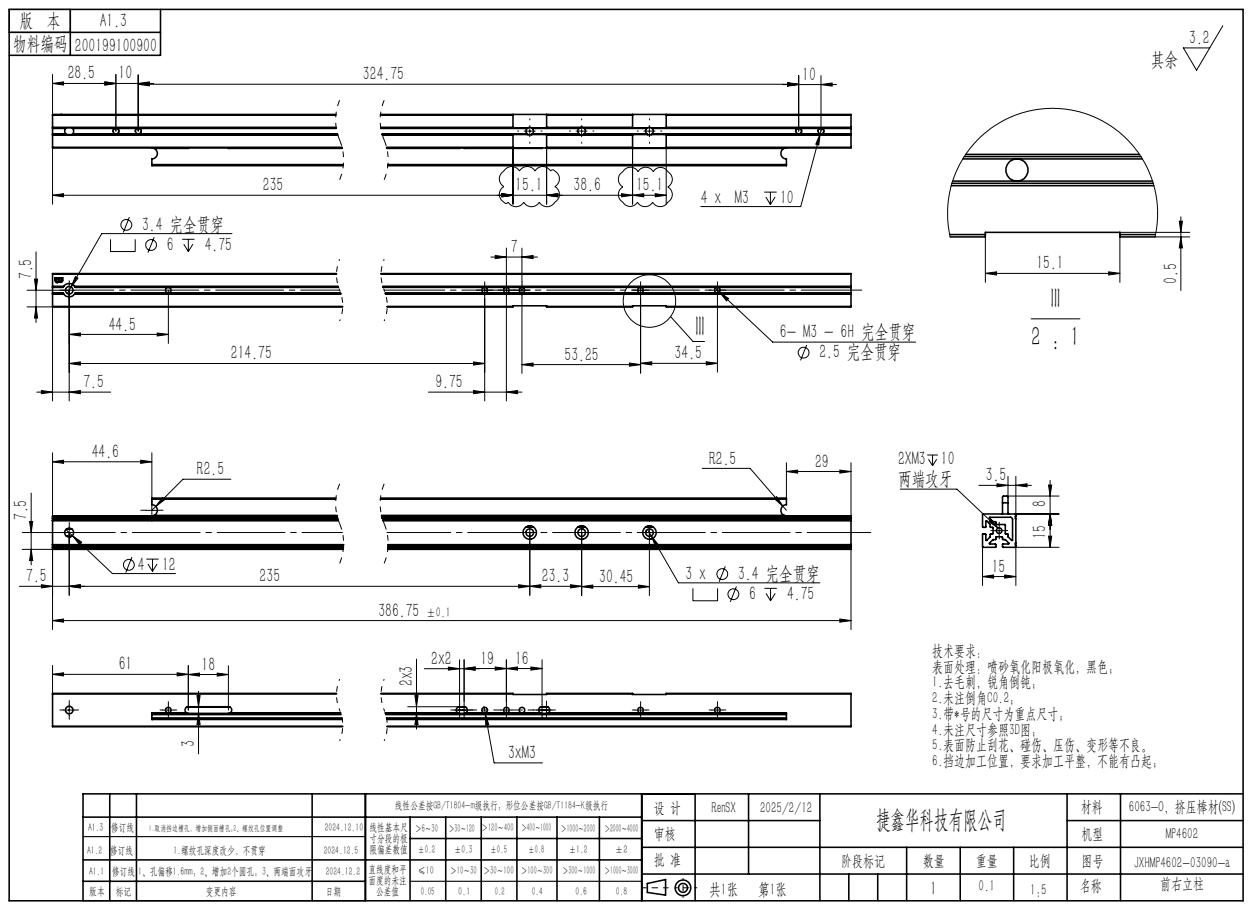
[picture p55: page 1]
3.4 完全贯穿; 6- M3 - 6H 完全贯穿 2.5 完全贯穿; 前右立柱 1; 物料编码 200199100900; 变更内容; A1.1 修订线 1、孔偏移1.6mm; 2、增加2个圆孔；3、两端面攻牙; A1.2 修订线; 1.螺纹孔深度改少，不贯穿; A1.3 修订线; 1.取消挡边槽孔，增加侧面槽孔;2、螺纹孔位置调整

技术要求：
表面处理：喷砂氧化阳极氧化，黑色；
1.去毛刺，锐角倒钝；
2.未注倒角C0.2；
3.带*号的尺寸为重点尺寸；
4.未注尺寸参照3D图；
5.表面防止刮花、碰伤、压伤、变形等不良。
6.挡边加工位置，要求加工平整，不能有凸起；

线性公差按GB/T1804-m级执行；形位公差按GB/T1184-K级执行
