Sovol3d/SOVOL-ZERO/PDF/开模塑胶件2025-1-14/JXHMP4602-06001-d 喷头外罩.pdf

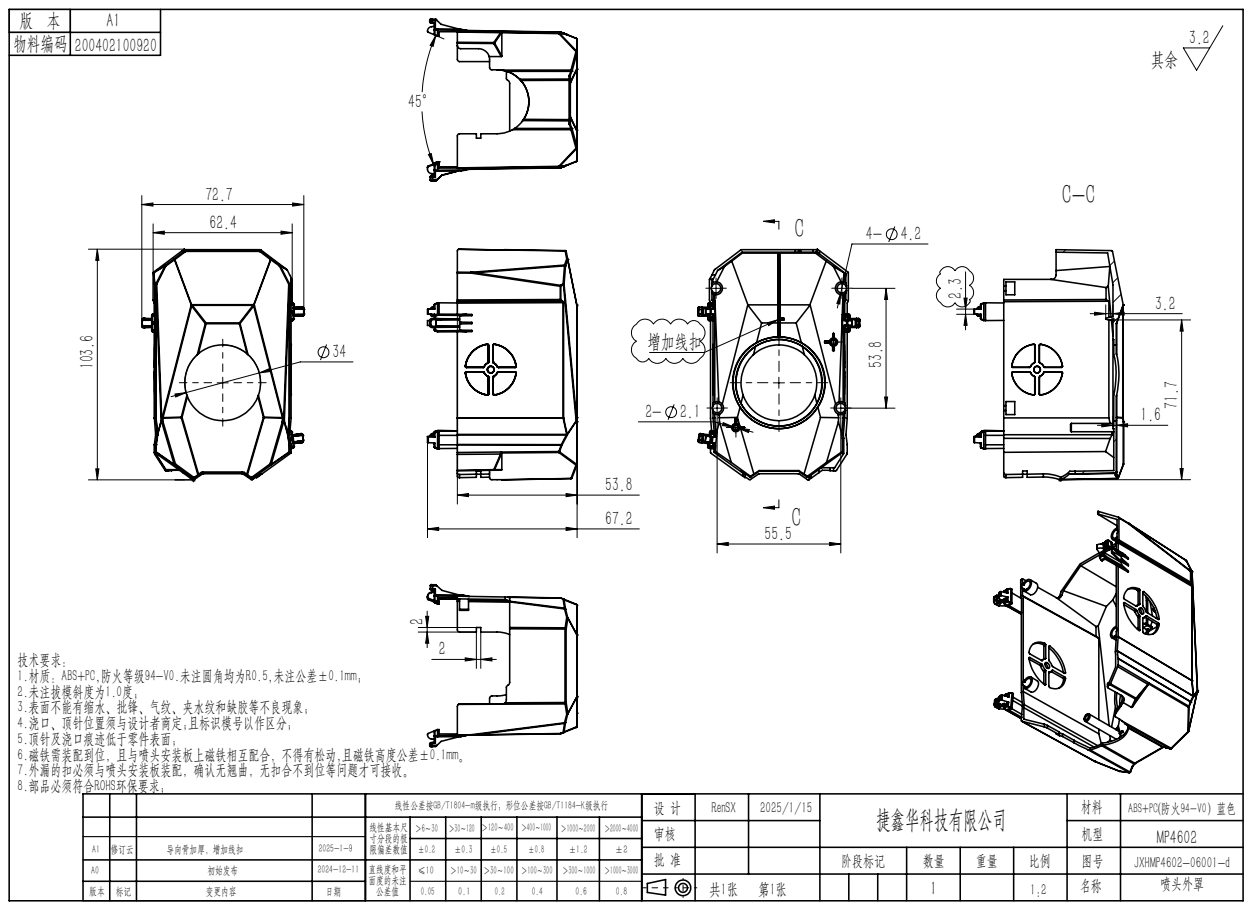
[picture p70: page 1]
喷头外罩 1; 物料编码 200402100920; 变更内容; A1 修订云; 导向骨加厚，增加线扣

技术要求:
1.材质：ABS+PC,防火等级94-V0.未注圆角均为R0.5,未注公差±0.1mm；
2.未注拔模斜度为1.0度；
3.表面不能有缩水、批锋、气纹、夹水纹和缺胶等不良现象；
4.浇口、顶针位置须与设计者商定;且标识模号以作区分；
5.顶针及浇口痕迹低于零件表面;
6.磁铁需装配到位，且与喷头安装板上磁铁相互配合，不得有松动,且磁铁高度公差±0.1mm。
7.外漏的扣必须与喷头安装板装配，确认无翘曲，无扣合不到位等问题才可接收。
8.部品必须符合ROHS环保要求；

线性公差按GB/T1804-m级执行；形位公差按GB/T1184-K级执行
