Sovol3d/SOVOL-ZERO/PDF/开模塑胶件2025-1-14/JXHSV05P-06008-d 喷头安装板.pdf

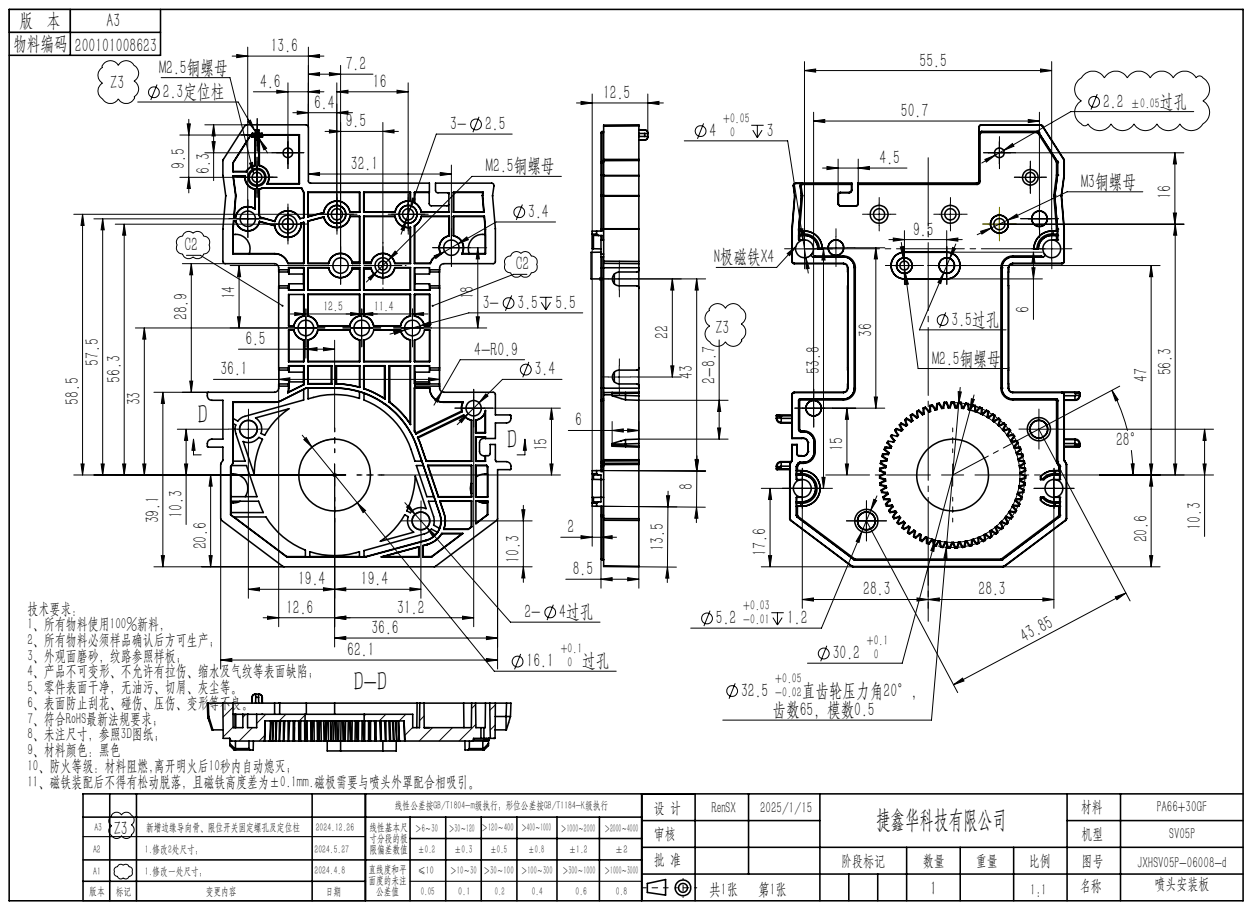
[picture p76: page 1]
2.3定位柱 9.5; 喷头安装板 1; 物料编码 200101008623; 变更内容

技术要求：
1、所有物料使用100%新料，
2、所有物料必须样品确认后方可生产；
3、外观面磨砂，纹路参照样板；
4、产品不可变形、不允许有拉伤、缩水及气纹等表面缺陷；
5、零件表面干净，无油污、切屑、灰尘等。
6、表面防止刮花、碰伤、压伤、变形等不良。
7、符合RoHS最新法规要求；
8、未注尺寸，参照3D图纸；
9、材料颜色：黑色
10、防火等级：材料阻燃,离开明火后10秒内自动熄灭；
11、磁铁装配后不得有松动脱落，且磁铁高度差为±0.1mm.磁极需要与喷头外罩配合相吸引。

线性公差按GB/T1804-m级执行；形位公差按GB/T1184-K级执行
