Sovol3d/SOVOL-ZERO/PDF/机加/JXHMP4602-12022-a 喷头板散热片.pdf

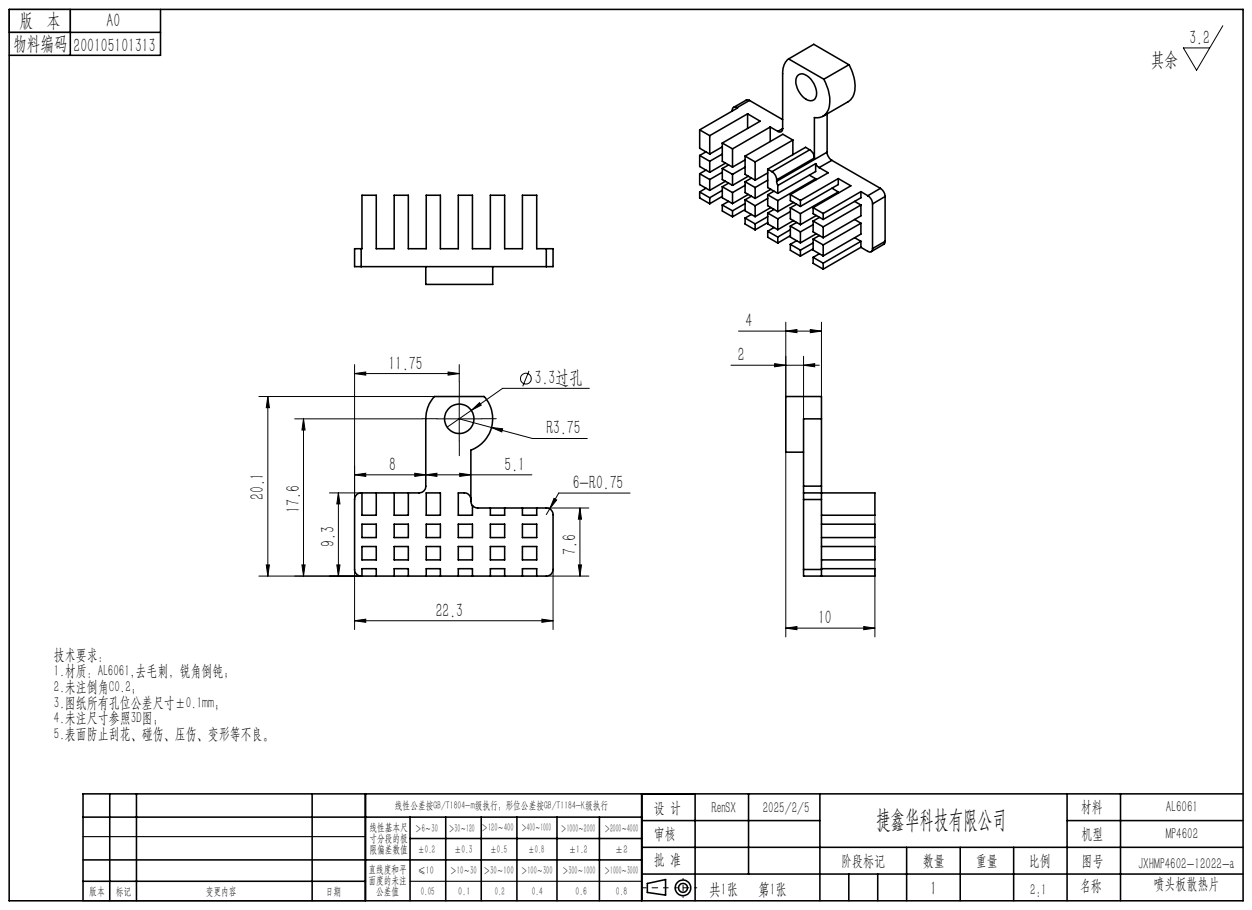
[picture p77: page 1]
物料编码 200105101313; 变更内容

技术要求：
1.材质：AL6061,去毛刺，锐角倒钝；
2.未注倒角C0.2；
3.图纸所有孔位公差尺寸±0.1mm；
4.未注尺寸参照3D图；
5.表面防止刮花、碰伤、压伤、变形等不良。

线性公差按GB/T1804-m级执行；形位公差按GB/T1184-K级执行
