Sovol3d/SOVOL-ZERO/PDF/滑轨/MGN9H1R197Z0 直线滑轨.pdf

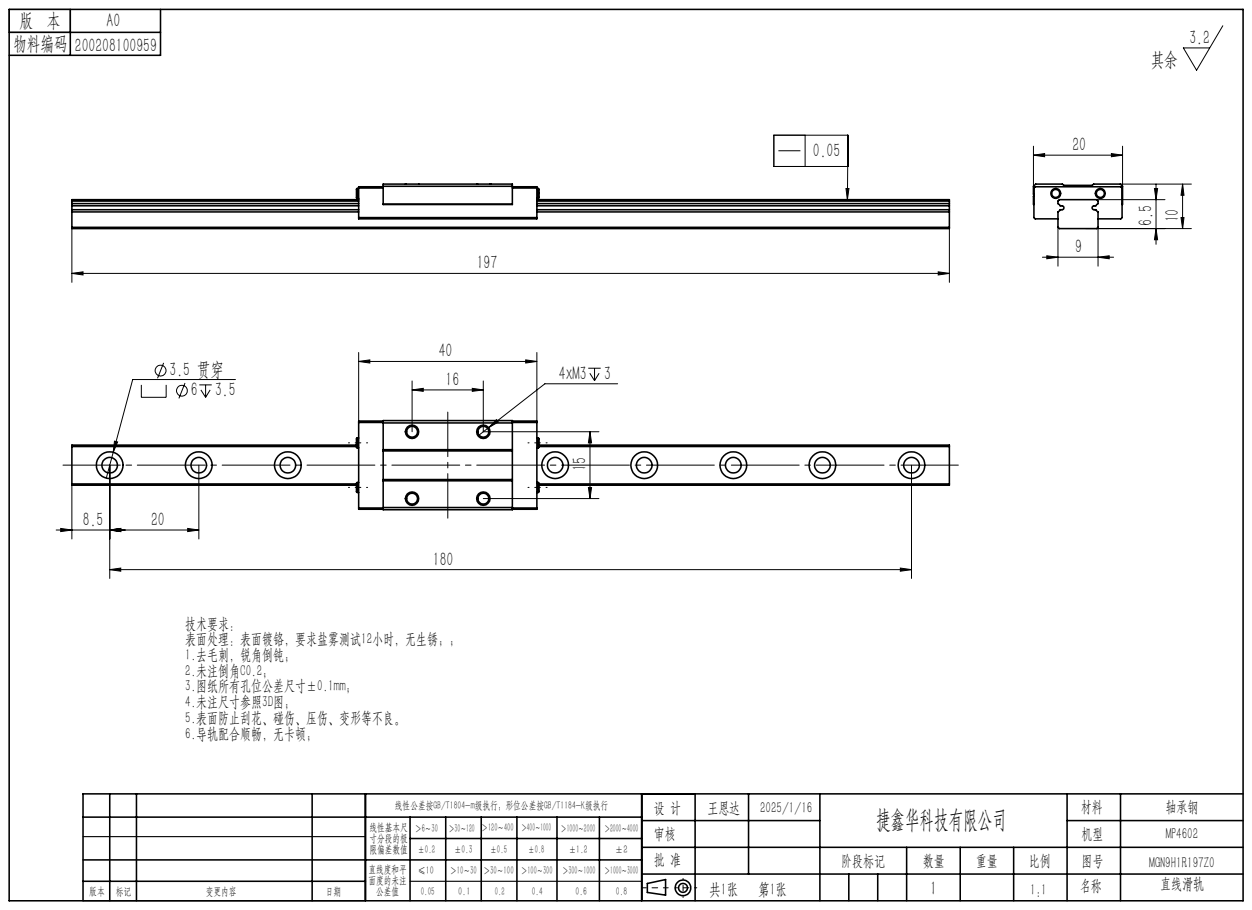
[picture p78: page 1]
直线滑轨 1; 物料编码 200208100959; 变更内容

技术要求：
表面处理：表面镀铬，要求盐雾测试12小时，无生锈；；
1.去毛刺，锐角倒钝；
2.未注倒角C0.2；
3.图纸所有孔位公差尺寸±0.1mm；
4.未注尺寸参照3D图；
5.表面防止刮花、碰伤、压伤、变形等不良。
6.导轨配合顺畅，无卡顿；

线性公差按GB/T1804-m级执行；形位公差按GB/T1184-K级执行
