Sovol3d/SOVOL-ZERO/PDF/PEI钢板/JXHMP4602-02014-f 打印平台钢板.pdf

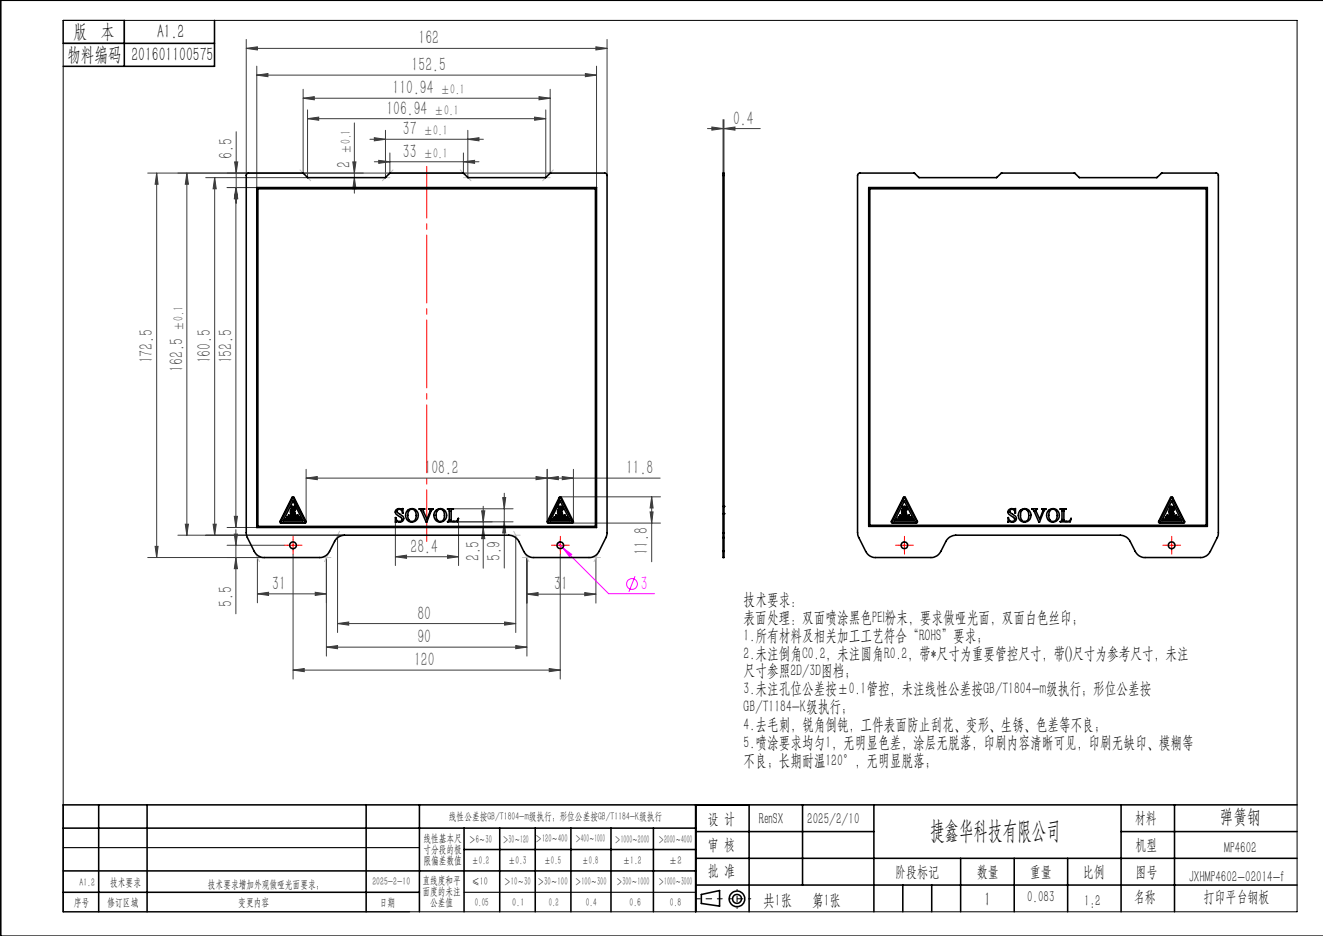
[picture p79: page 1]

技术要求：
表面处理：双面喷涂黑色PEI粉末，要求做哑光面，双面白色丝印；
1.所有材料及相关加工工艺符合“ROHS”要求；
2.未注倒角C0.2，未注圆角R0.2，带*尺寸为重要管控尺寸，带()尺寸为参考尺寸，未注
尺寸参照2D/3D图档；
3.未注孔位公差按±0.1管控，未注线性公差按GB/T1804-m级执行；形位公差按
GB/T1184-K级执行；
4.去毛刺，锐角倒钝，工件表面防止刮花、变形、生锈、色差等不良；
5.喷涂要求均匀1，无明显色差，涂层无脱落，印刷内容清晰可见，印刷无缺印、模糊等
不良；长期耐温120°，无明显脱落；

线性公差按GB/T1804-m级执行；形位公差按GB/T1184-K级执行
