Sovol3d/SOVOL-ZERO/PDF/华测信/JXHMP4602-02015-f  压力传感器.pdf

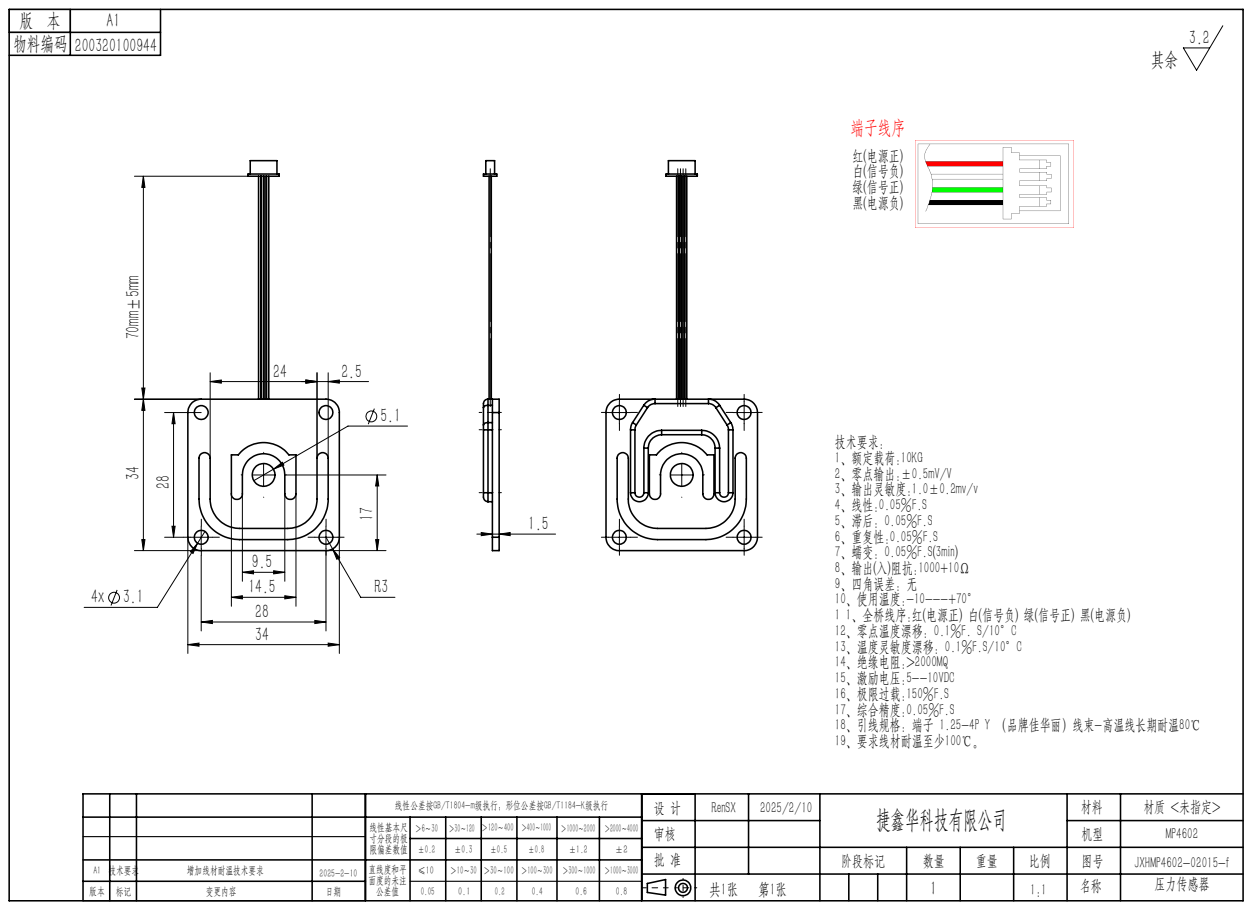
[picture p81: page 1]
45#加硬处理 技术要求:; 7、蠕变: 0.05%F.S(3min); 1 1、全桥线序:红(电源正) 白(信号负) 绿(信号正) 黑(电源负) 12、零点温度漂移: 0.1%F. S/10°C 13、温度灵敏度漂移: 0.1%F.S/10°C; 18、引线规格：端子 1.25-4P Y （品牌佳华丽）线束-高温线长期耐温80℃; 材质 <未指定>; 压力传感器 1; 物料编码 200320100944; 变更内容; 技术要求; 增加线材耐温技术要求

线性公差按GB/T1804-m级执行；形位公差按GB/T1184-K级执行
