Sovol3d/SOVOL-ZERO/PDF/型材/JXHMP4602-03019-a 后下立柱.pdf

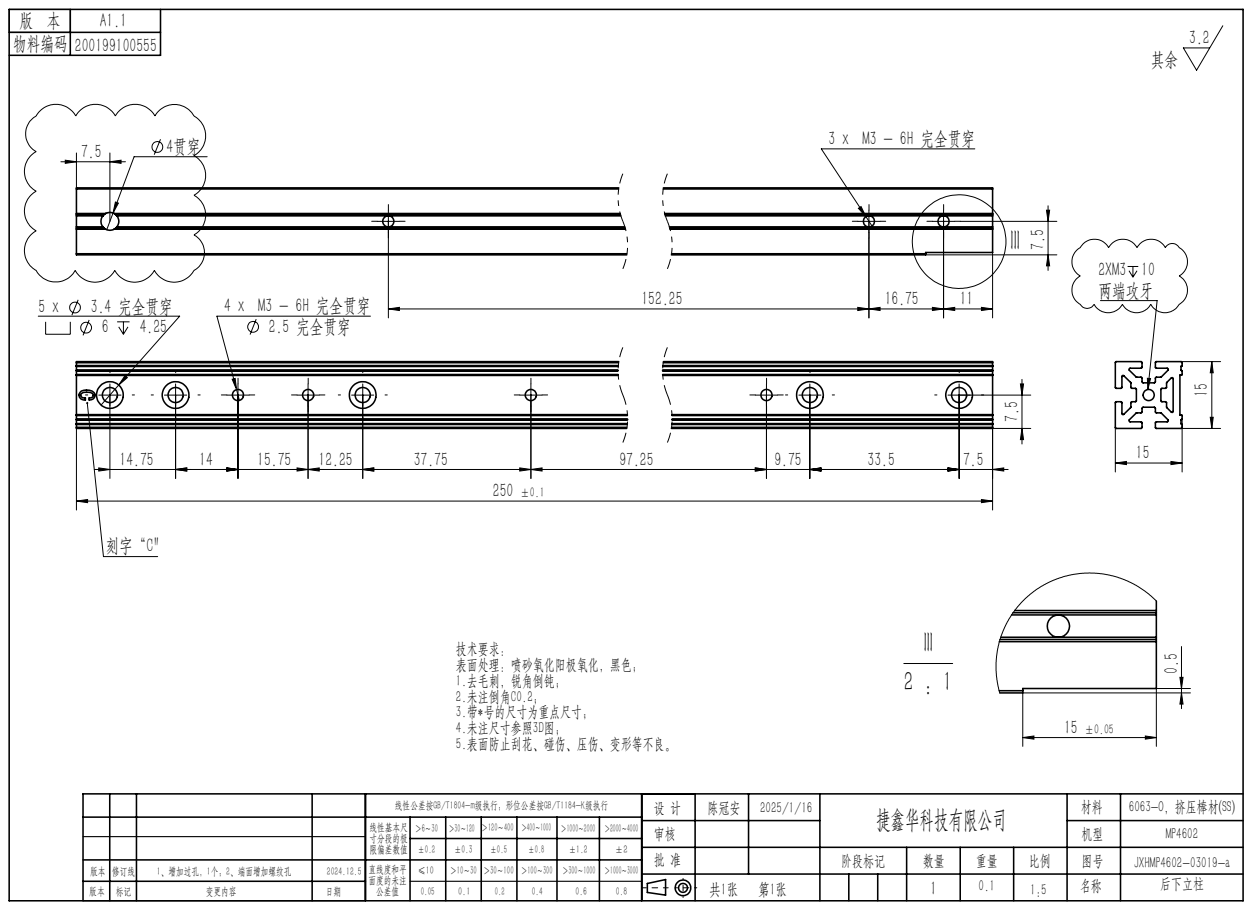
[picture p83: page 1]
3.4 完全贯穿; 4 x M3 - 6H 完全贯穿 2.5 完全贯穿; 两端攻牙 16.75; 3 x M3 - 6H 完全贯穿; 技术要求; 后下立柱 1; 物料编码 200199100555; 变更内容; 版本 修订线; 1、增加过孔，1个；2、端面增加螺纹孔

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

线性公差按GB/T1804-m级执行；形位公差按GB/T1184-K级执行
