Sovol3d/SOVOL-ZERO/PDF/型材/JXHMP4602-03022-a 底部纵梁.pdf

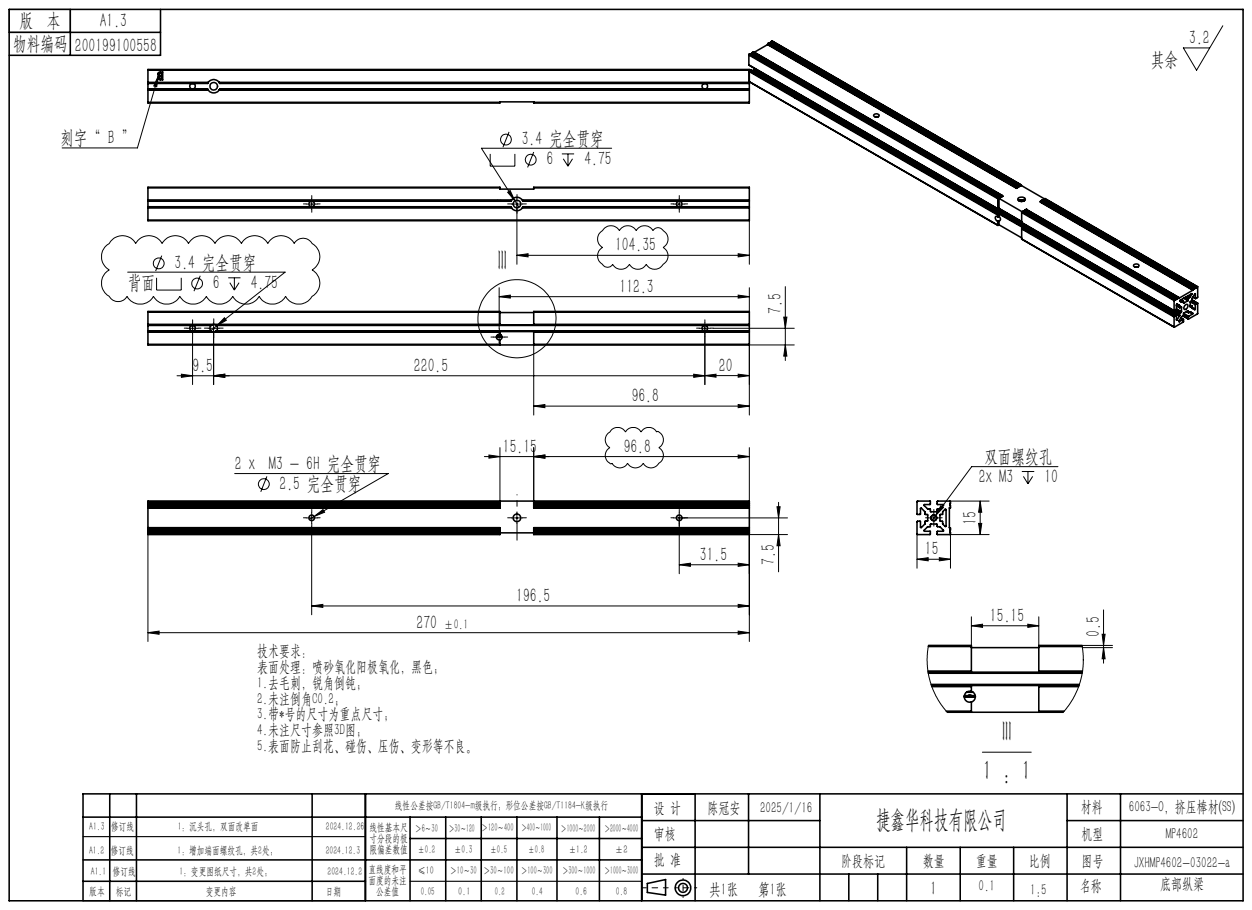
[picture p85: page 1]
2 x M3 - 6H 完全贯穿 2.5 完全贯穿; 3.4 完全贯穿; 底部纵梁 1; 物料编码 200199100558; 变更内容; A1.1 修订线; 1：变更图纸尺寸，共2处；; A1.2 修订线; 1：增加端面螺纹孔，共2处；; A1.3 修订线; 1：沉头孔，双面改单面

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

线性公差按GB/T1804-m级执行；形位公差按GB/T1184-K级执行
