Sovol3d/SOVOL-ZERO/PDF/型材/JXHMP4602-03023-a 底后横梁.pdf

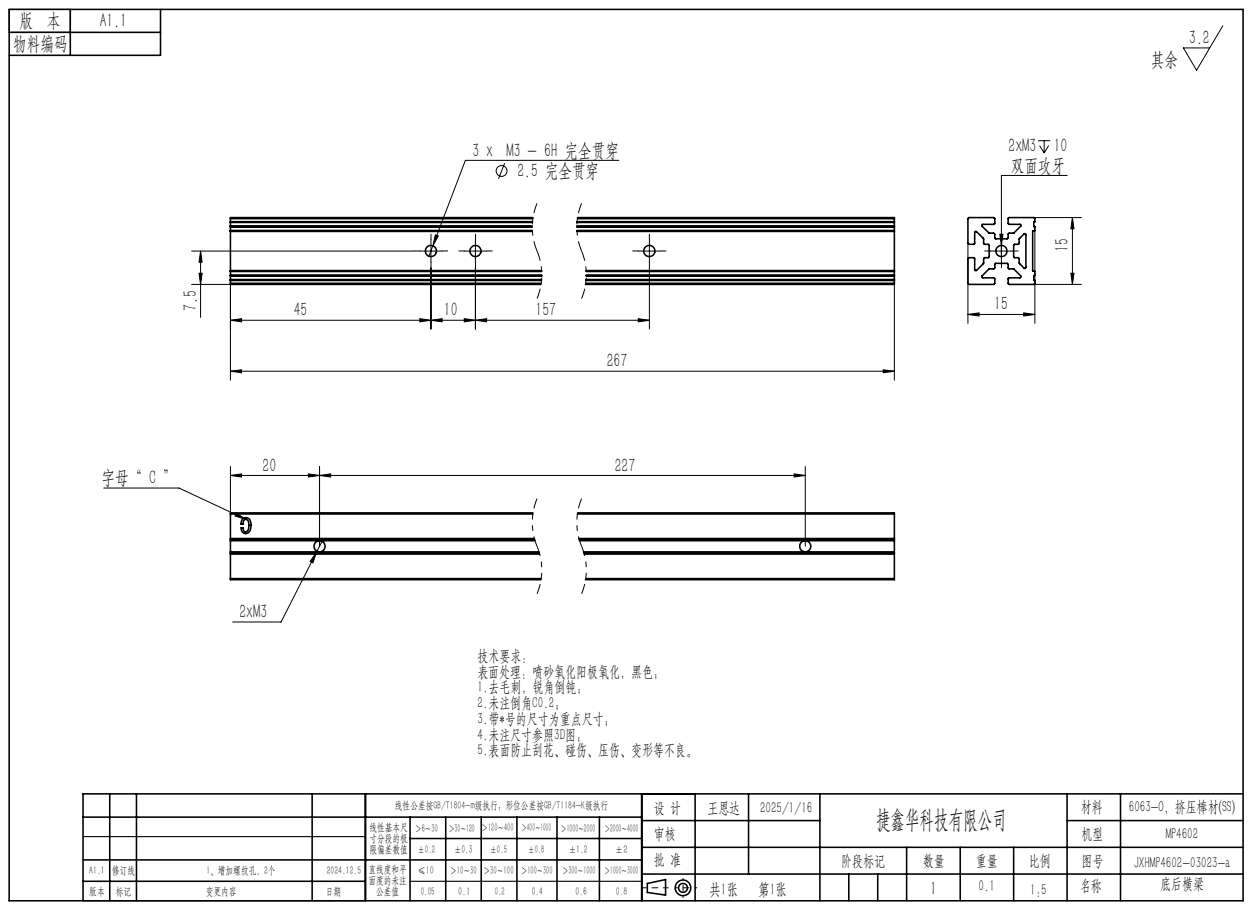
[picture p86: page 1]
3 x M3 - 6H 完全贯穿 2.5 完全贯穿; 底后横梁 1; 变更内容; A1.1 修订线; 1、增加螺纹孔，2个

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

线性公差按GB/T1804-m级执行；形位公差按GB/T1184-K级执行
