Sovol3d/SOVOL-ZERO/PDF/型材/JXHMP4602-03032-a 后中横梁.pdf

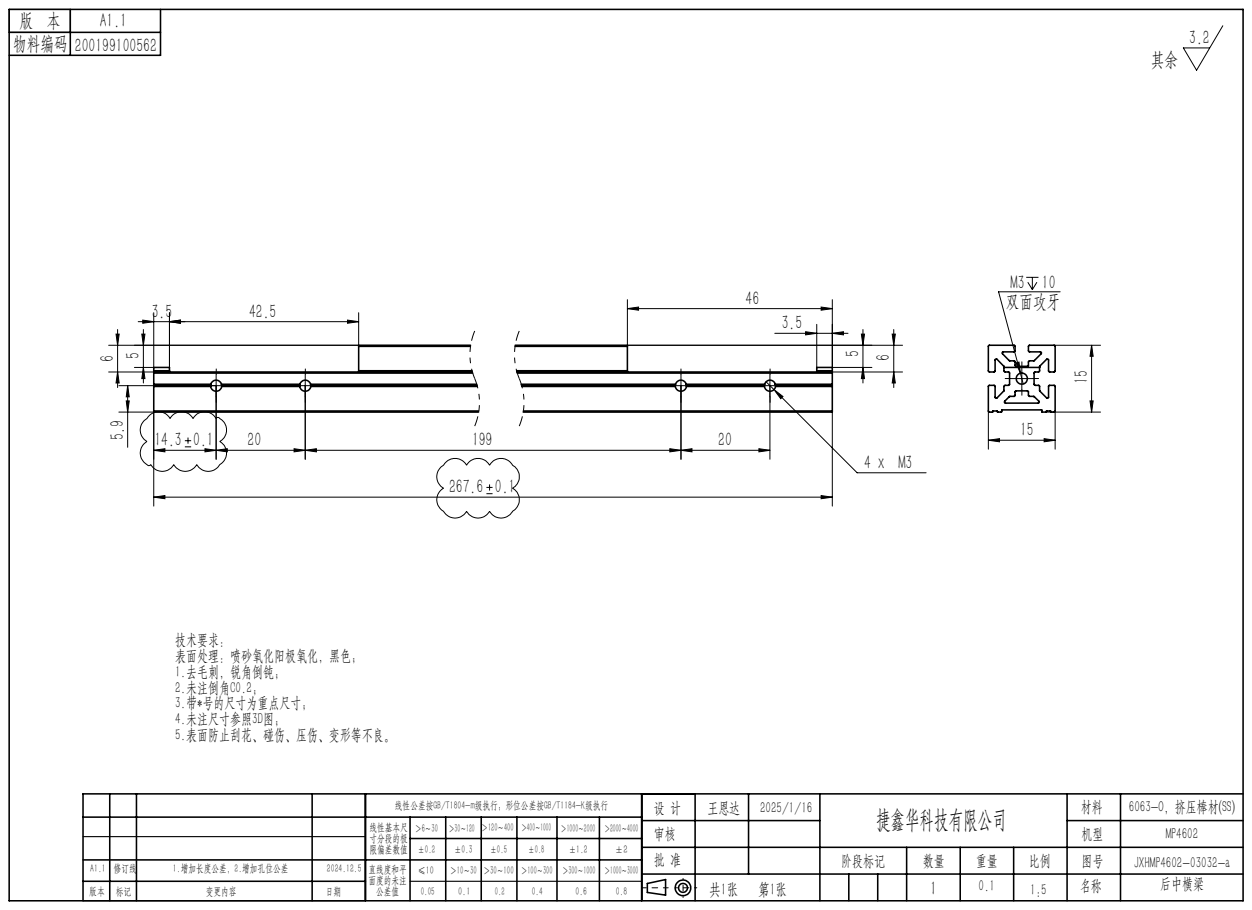
[picture p89: page 1]
后中横梁 1; 物料编码 200199100562; 变更内容; A1.1 修订线; 1.增加长度公差，2.增加孔位公差

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

线性公差按GB/T1804-m级执行；形位公差按GB/T1184-K级执行
