Sovol3d/SOVOL-ZERO/PDF/型材/JXHMP4602-03034-a 后上横梁.pdf

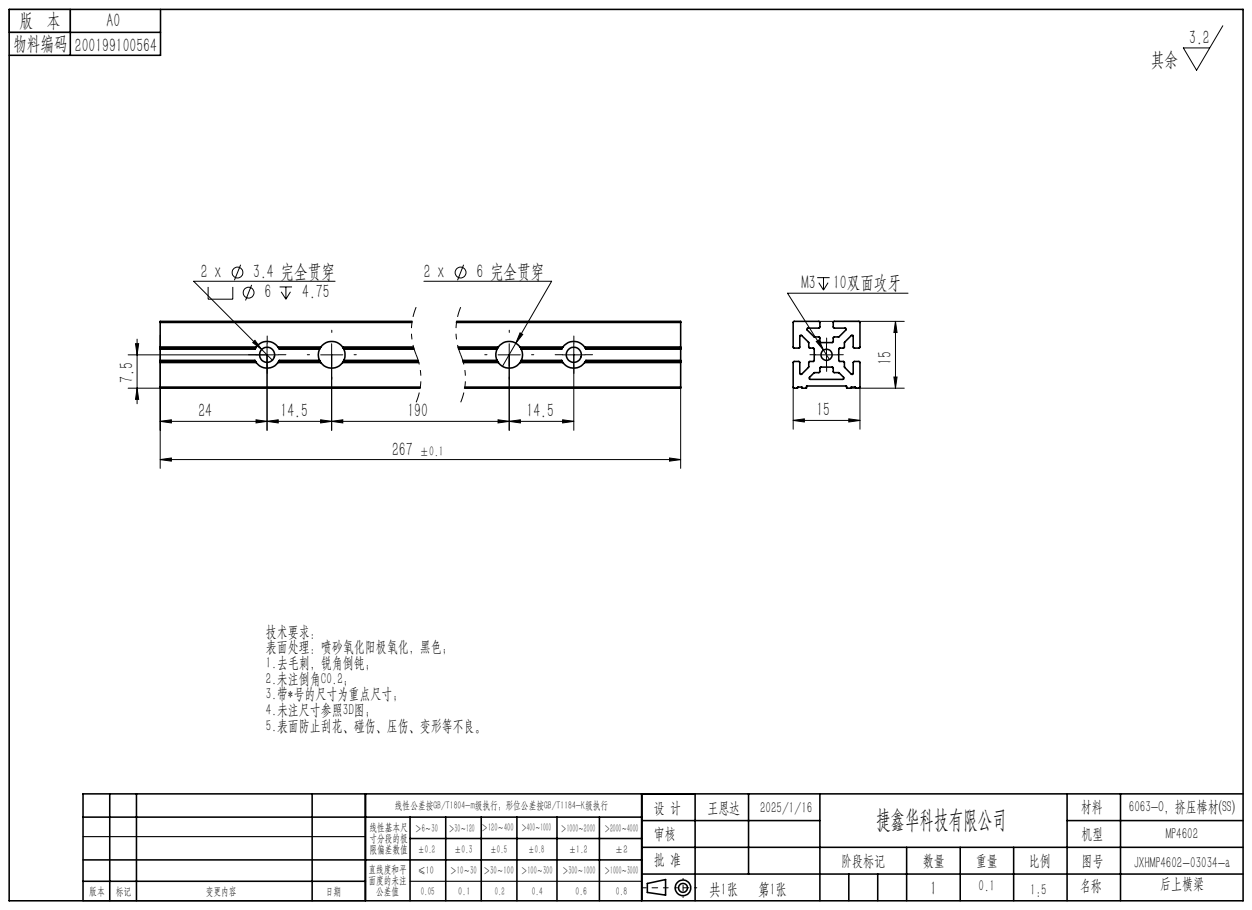
[picture p90: page 1]
3.4 完全贯穿; 6 完全贯穿; M3 10双面攻牙; 后上横梁 1; 物料编码 200199100564; 变更内容

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

线性公差按GB/T1804-m级执行；形位公差按GB/T1184-K级执行
