Sovol3d/SOVOL-ZERO/PDF/型材/JXHMP4602-03039-a 顶上立柱.pdf

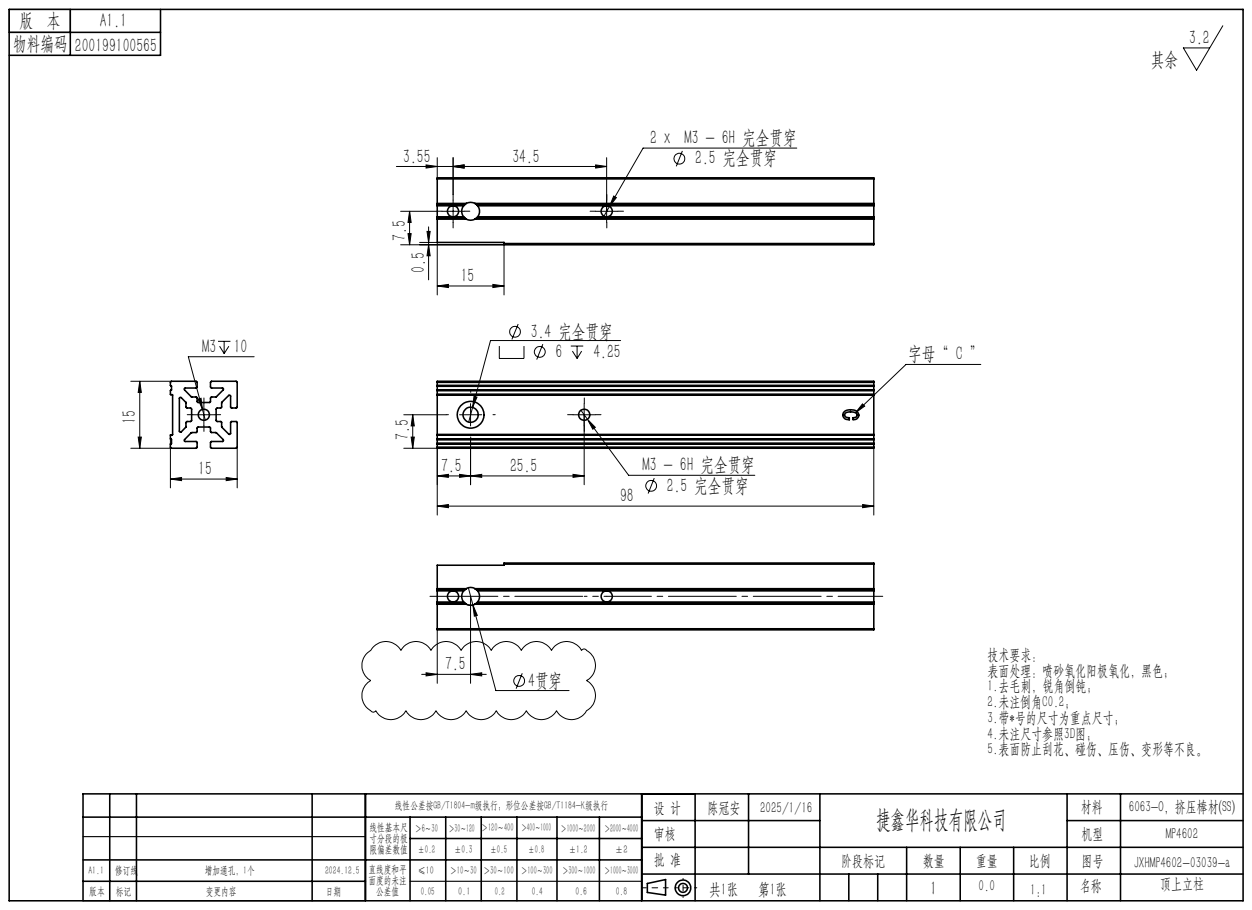
[picture p91: page 1]
3.4 完全贯穿; M3 - 6H 完全贯穿 2.5 完全贯穿; 2 x M3 - 6H 完全贯穿 2.5 完全贯穿; 顶上立柱 1; 物料编码 200199100565; 变更内容; A1.1 修订线; 增加通孔，1个

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

线性公差按GB/T1804-m级执行；形位公差按GB/T1184-K级执行
