Sovol3d/SOVOL-ZERO/PDF/型材/JXHMP4602-03040-a 顶前型材.pdf

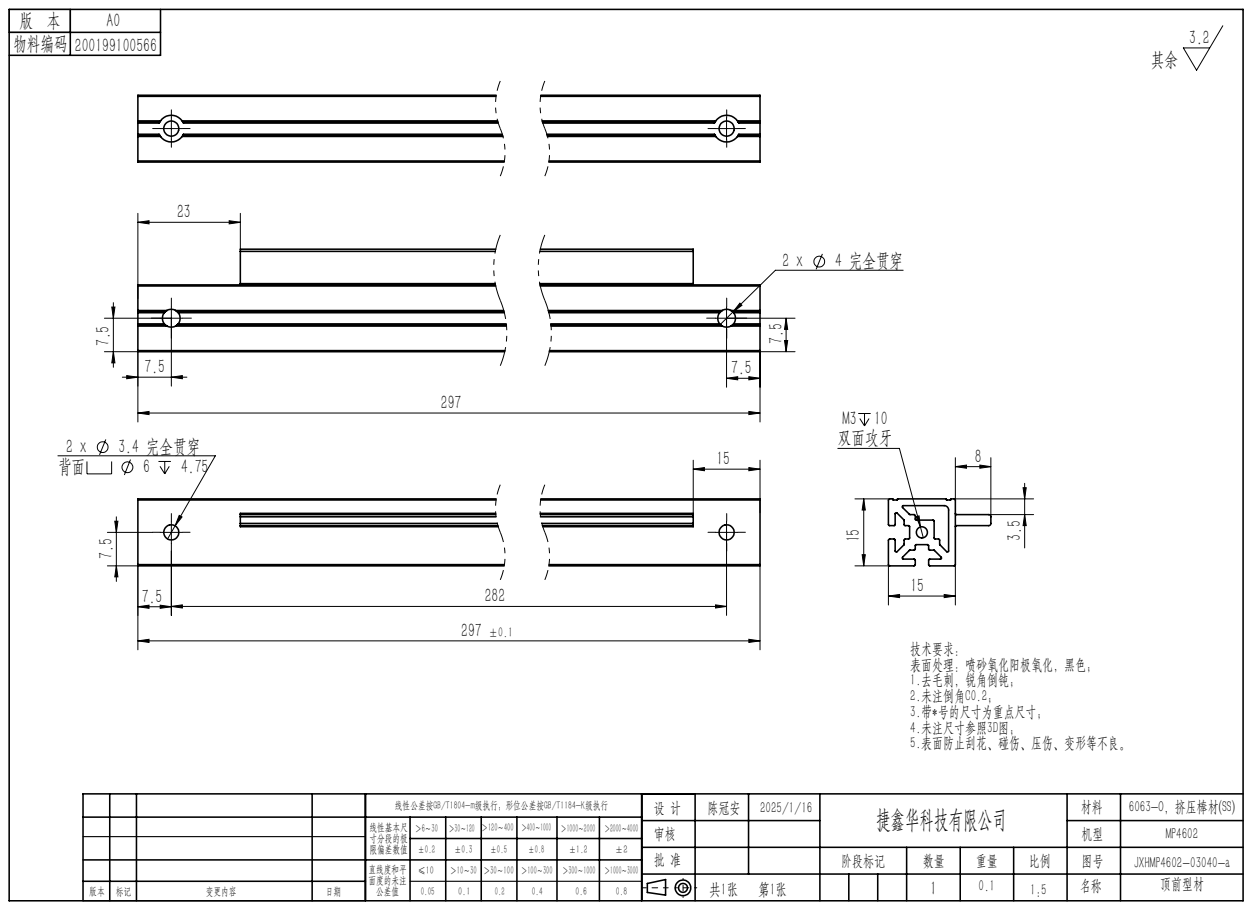
[picture p92: page 1]
3.4 完全贯穿; M3 10 双面攻牙 15; 4 完全贯穿; 顶前型材 1; 物料编码 200199100566; 变更内容

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

线性公差按GB/T1804-m级执行；形位公差按GB/T1184-K级执行
