Sovol3d/SOVOL-ZERO/PDF/型材/JXHMP4602-03041-a 顶后型材.pdf

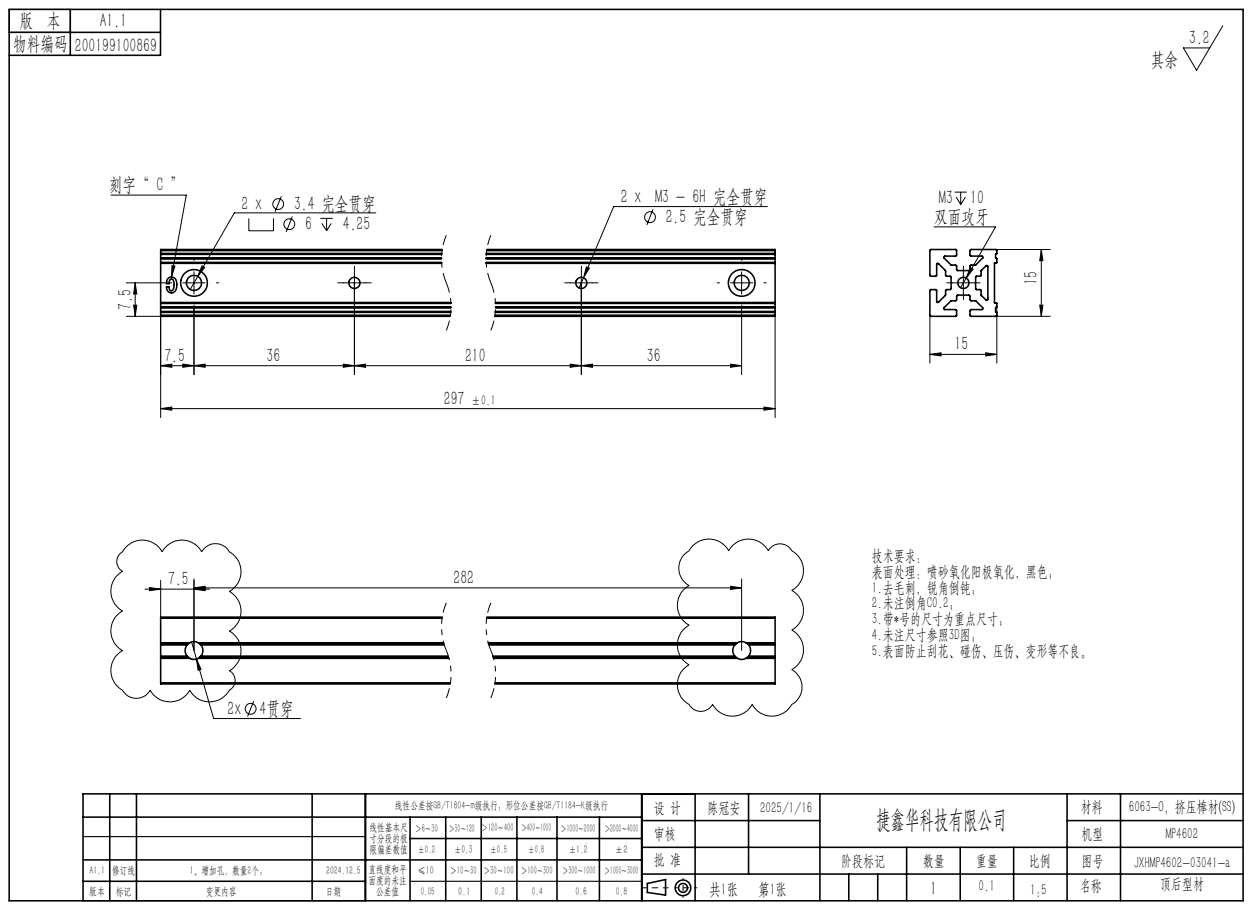
[picture p93: page 1]
3.4 完全贯穿; 2 x M3 - 6H 完全贯穿 2.5 完全贯穿; 技术要求; 顶后型材 1; 物料编码 200199100869; 变更内容; A1.1 修订线; 1、增加孔，数量2个；

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

线性公差按GB/T1804-m级执行；形位公差按GB/T1184-K级执行
