Sovol3d/SOVOL-ZERO/PDF/型材/JXHMP4602-03092-a 底部左纵梁.pdf

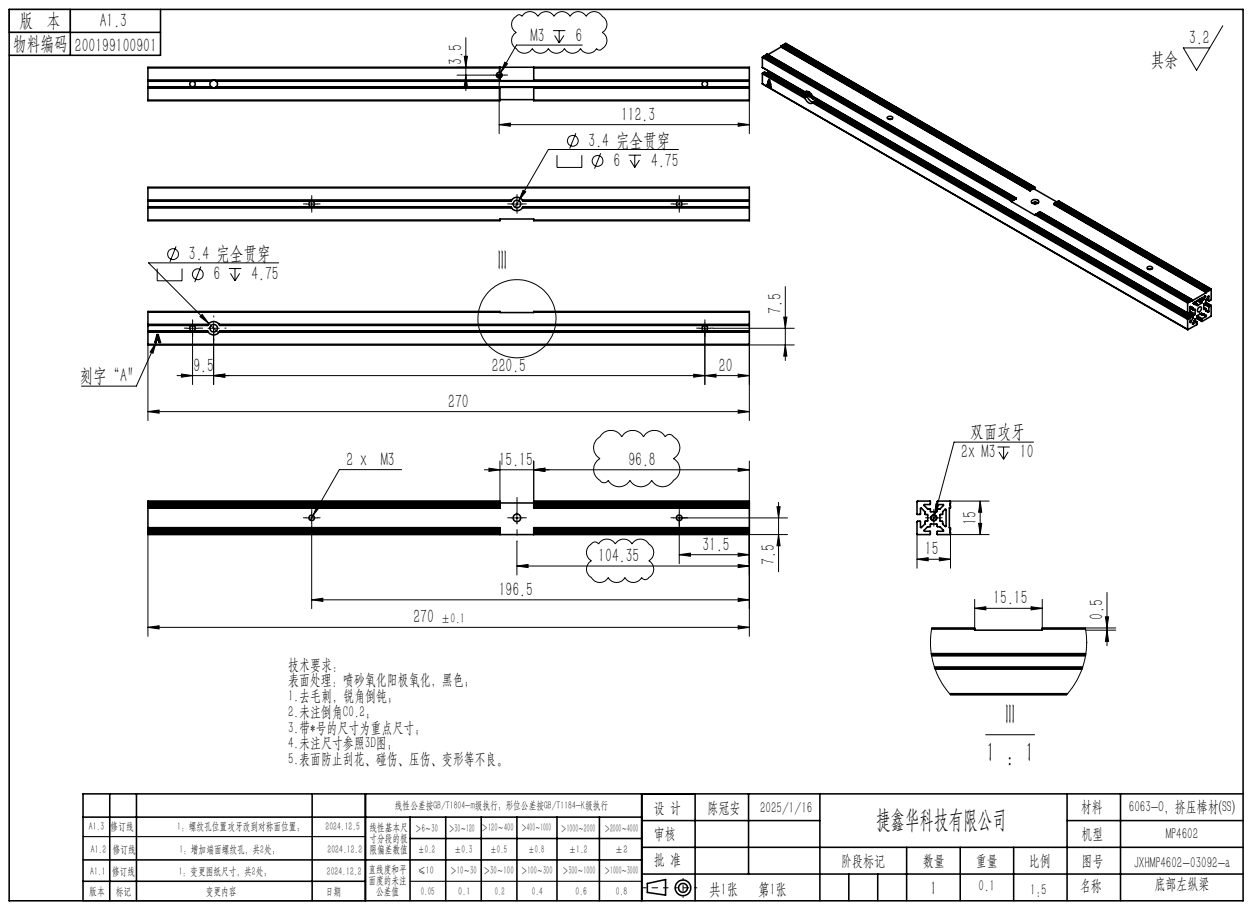
[picture p95: page 1]
3.4 完全贯穿; 底部左纵梁 1; 物料编码 200199100901; 变更内容; A1.1 修订线; 1：变更图纸尺寸，共2处；; A1.2 修订线; 1：增加端面螺纹孔，共2处；; A1.3 修订线; 1：螺纹孔位置攻牙改到对称面位置；

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

线性公差按GB/T1804-m级执行；形位公差按GB/T1184-K级执行
