Sovol3d/SOVOL-ZERO/PDF/型材/JXHMP4602-05048-a X轴横梁.pdf

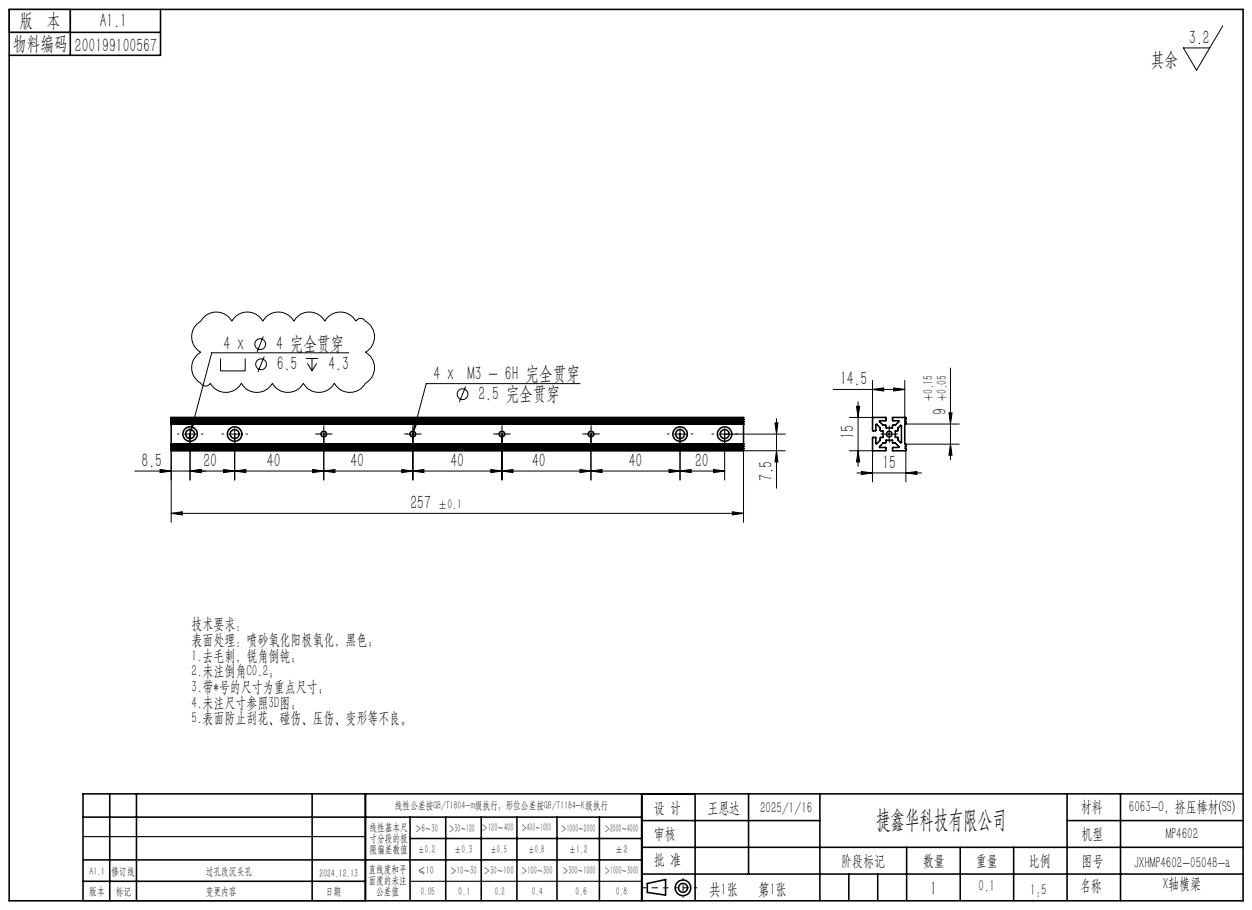
[picture p96: page 1]
4 x M3 - 6H 完全贯穿 2.5 完全贯穿; 4 完全贯穿; X轴横梁 1; 物料编码 200199100567; 变更内容; A1.1 修订线; 过孔改沉头孔

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

线性公差按GB/T1804-m级执行；形位公差按GB/T1184-K级执行
