Sovol3d/SOVOL-ZERO/PDF/开关电源盖板/JXHMP4602-04049-a 开关电源盖板.pdf

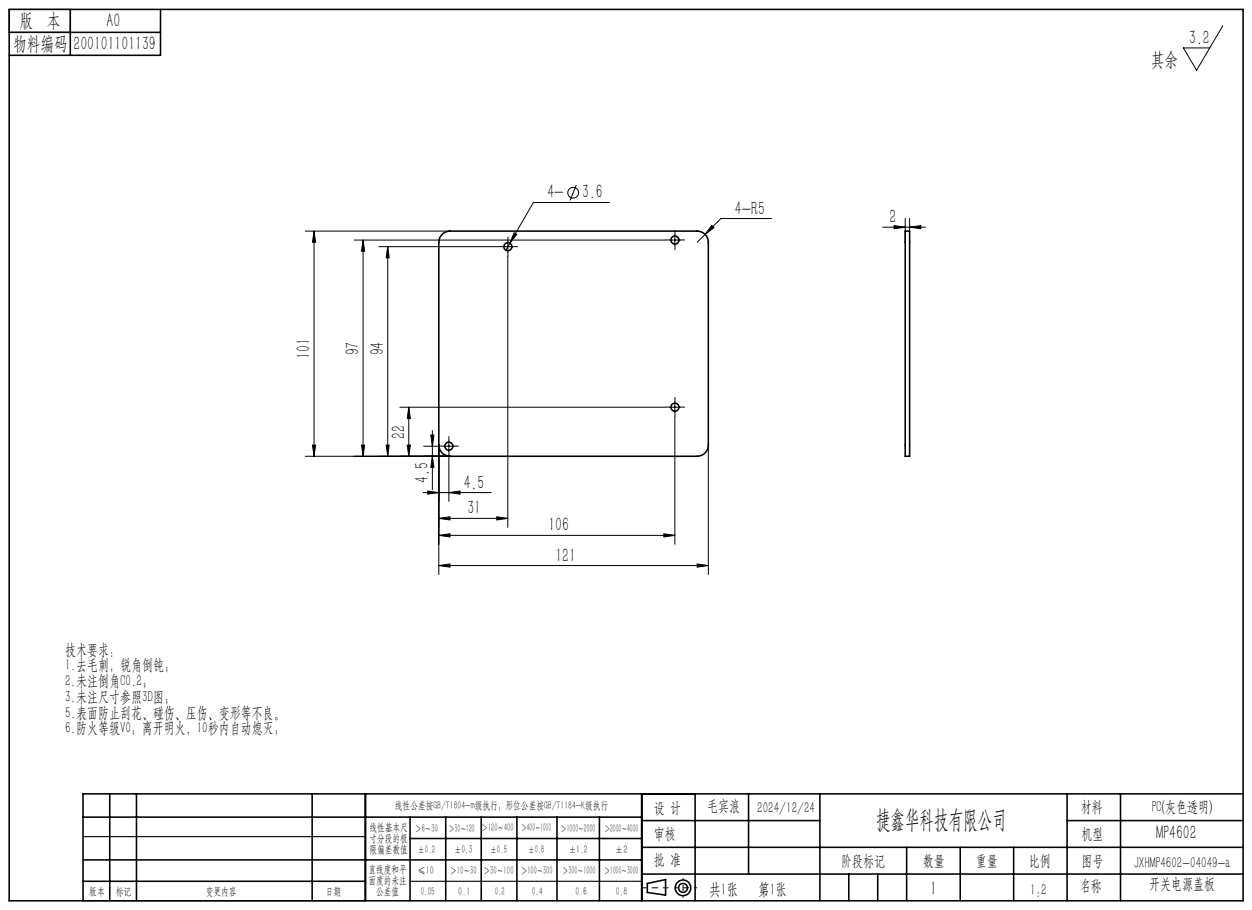
[picture p97: page 1]
开关电源盖板 1; 变更内容

线性公差按GB/T1804-m级执行；形位公差按GB/T1184-K级执行
