Sovol3d/SOVOL-ZERO/PDF/开模塑胶件2025-1-14/JXHMP4602-06004-f 硅胶套.pdf

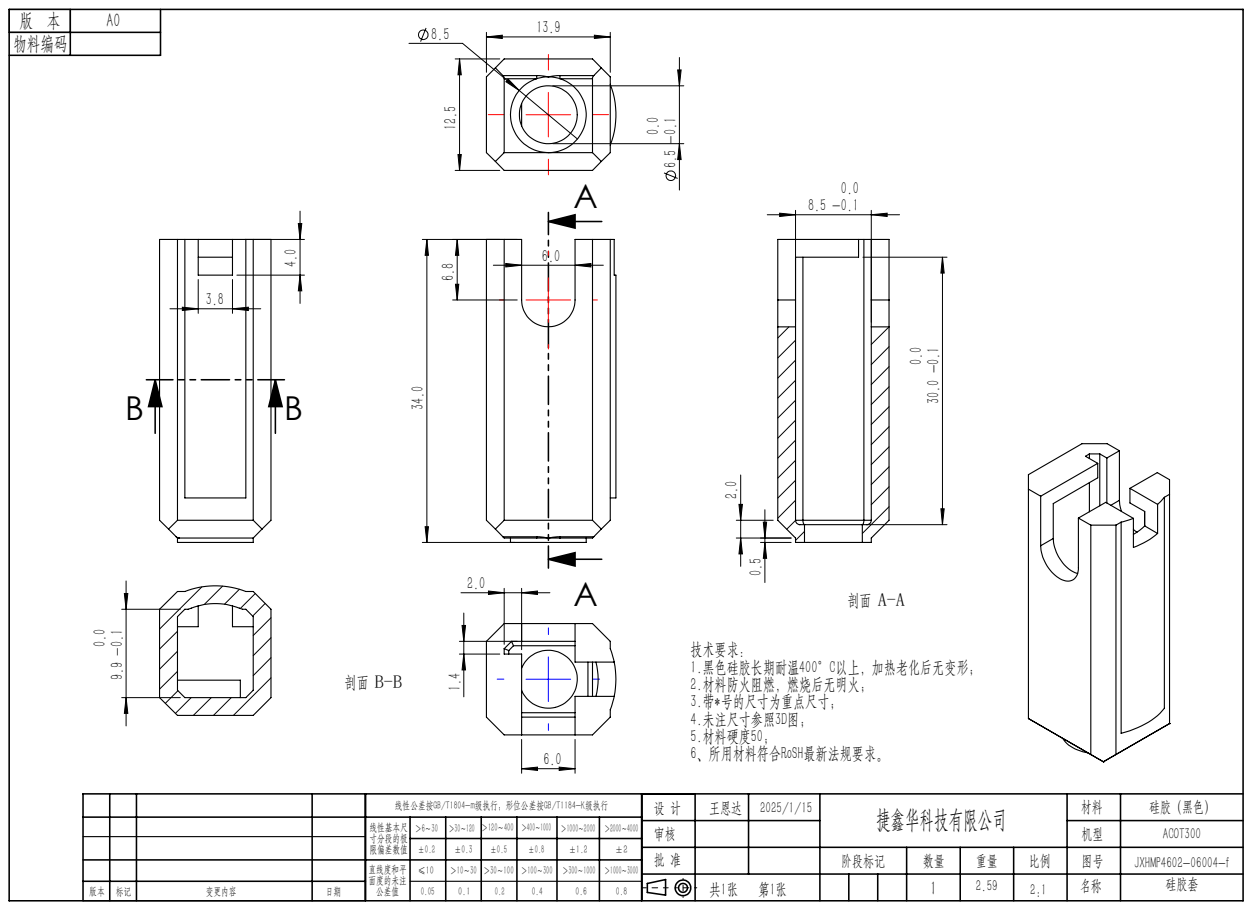
[picture p98: page 1]
硅胶套 1; 变更内容

线性公差按GB/T1804-m级执行；形位公差按GB/T1184-K级执行
