Sovol3d/SOVOL-ZERO/PDF/机加/JXHMP4062-08048-a 加热块.pdf

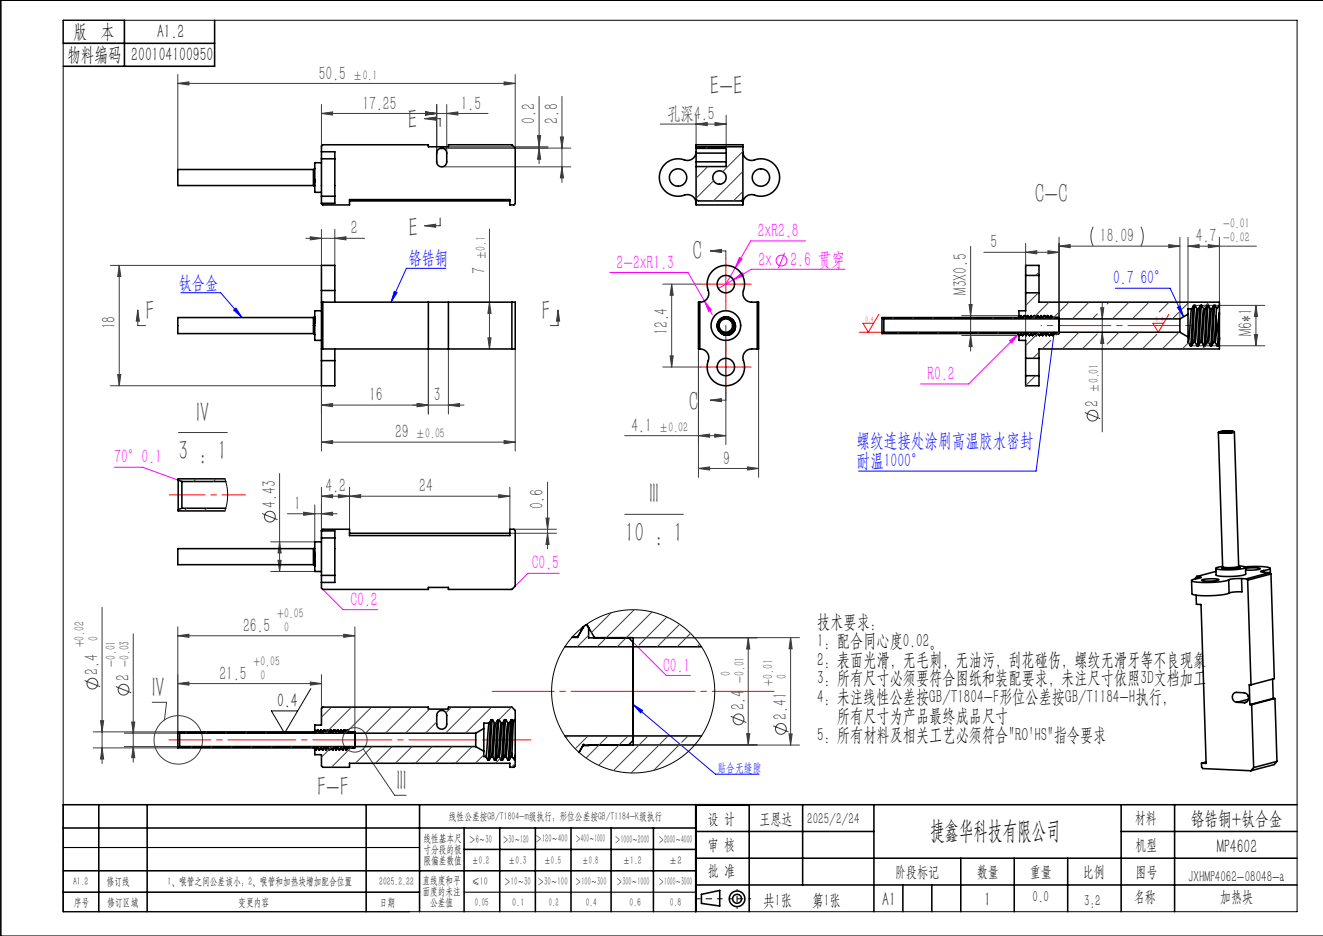
[picture p99: page 1]
王恩达 2025/2/24

技术要求:
1：配合同心度0.02。
2：表面光滑，无毛刺，无油污，刮花碰伤，螺纹无滑牙等不良现象
3：所有尺寸必须要符合图纸和装配要求，未注尺寸依照3D文档加工
4：未注线性公差按GB/T1804-F形位公差按GB/T1184-H执行，
所有尺寸为产品最终成品尺寸
5：所有材料及相关工艺必须符合"RO'HS"指令要求

线性公差按GB/T1804-m级执行；形位公差按GB/T1184-K级执行
