Sovol3d/SOVOL-ZERO/PDF/机加/JXHMP4602-08050-a 黄铜喷嘴.pdf

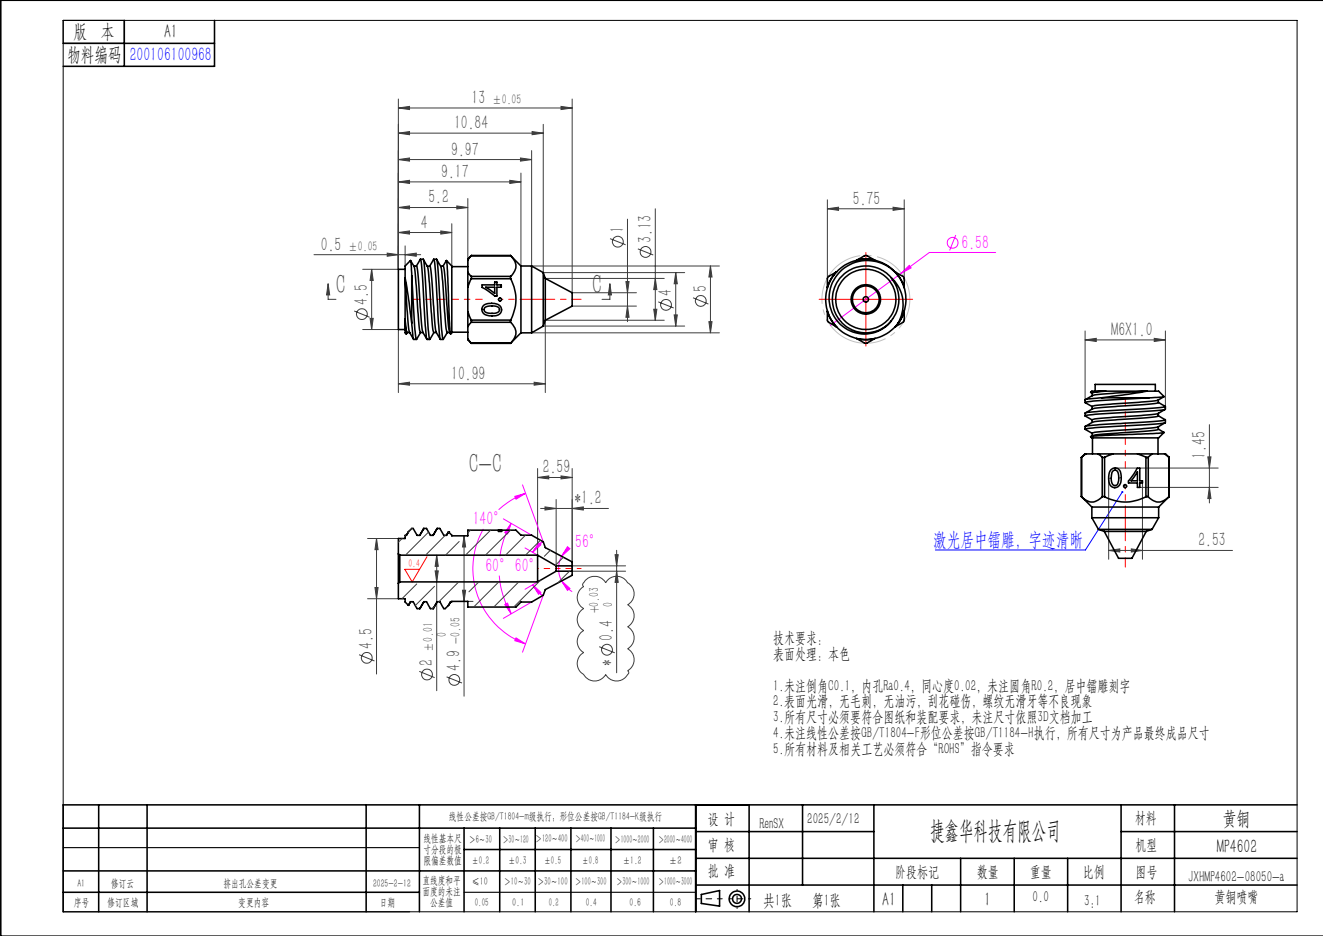
[picture p104: page 1]

1.未注倒角C0.1，内孔Ra0.4，同心度0.02，未注圆角R0.2，居中镭雕刻字
2.表面光滑，无毛刺，无油污，刮花碰伤，螺纹无滑牙等不良现象
3.所有尺寸必须要符合图纸和装配要求，未注尺寸依照3D文档加工
4.未注线性公差按GB/T1804-F形位公差按GB/T1184-H执行，所有尺寸为产品最终成品尺寸
5.所有材料及相关工艺必须符合“ROHS”指令要求

线性公差按GB/T1804-m级执行；形位公差按GB/T1184-K级执行
