Sovol3d/SOVOL-ZERO/PDF/活性炭过滤盒/JXHMP4602-06056-d 活性炭过滤耗材盒.pdf

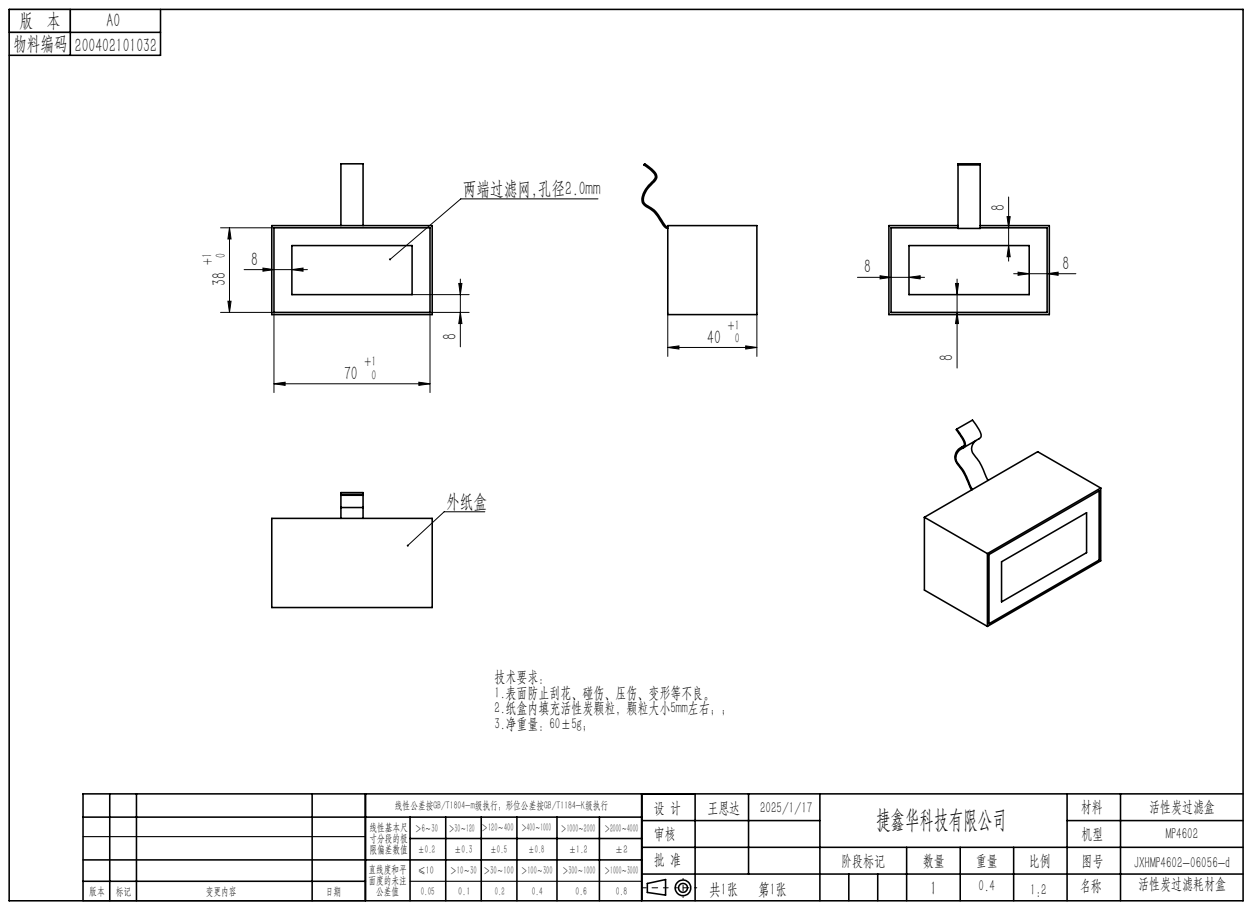
[picture p105: page 1]
活性炭过滤耗材盒 1; 物料编码 200402101032; 变更内容

技术要求：
1.表面防止刮花、碰伤、压伤、变形等不良。
2.纸盒内填充活性炭颗粒，颗粒大小5mm左右；；
3.净重量：60±5g;

线性公差按GB/T1804-m级执行；形位公差按GB/T1184-K级执行
