Sovol3d/SOVOL-ZERO/PDF/温度传感器 PT1000B/JXHMP4602-08052-f 温度传感器 PT1000B-模型.pdf

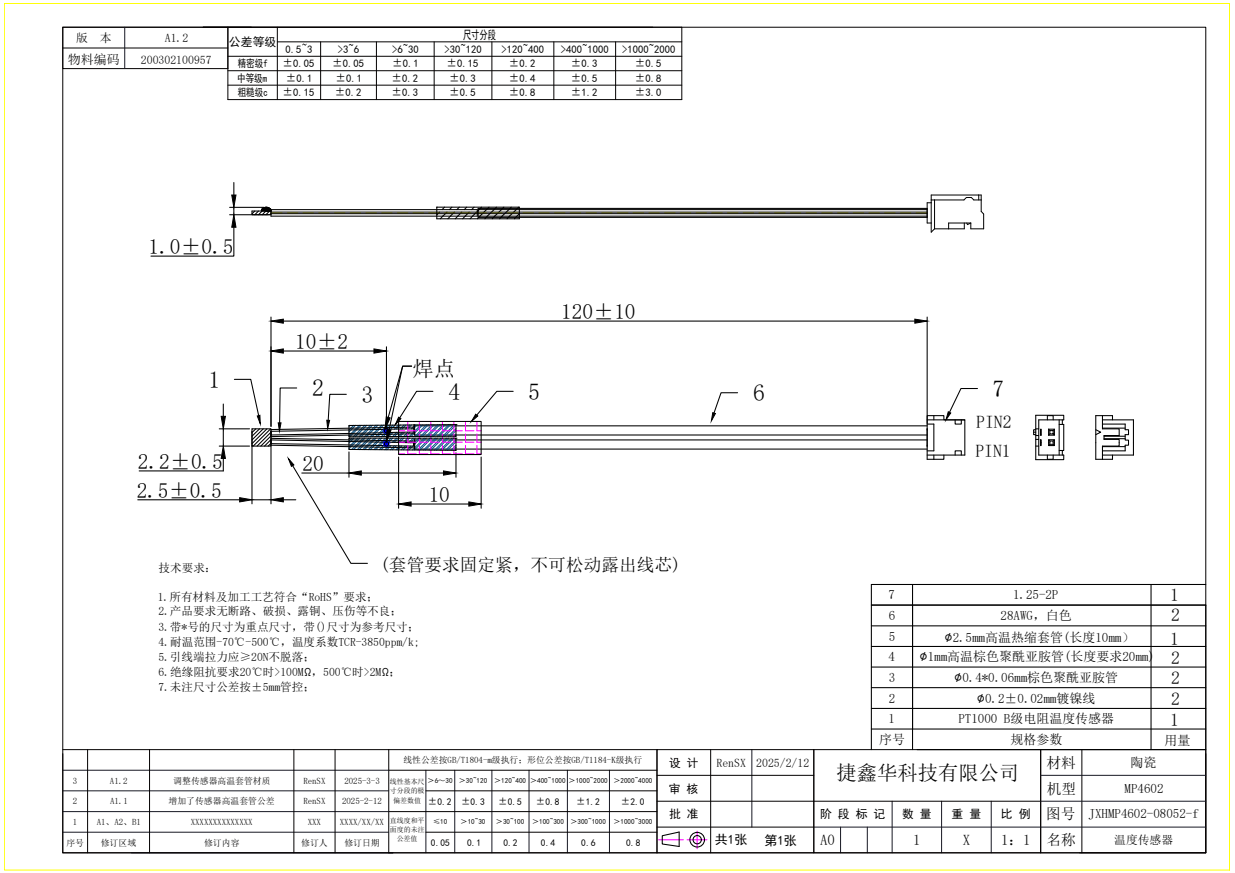
[picture p106: page 1]

版 本 | A1.2 | 公差等级 | 尺寸分段

物料编码 | 200302100957

精密级f | ±0.05 | ±0.05 | ±0.1 | ±0.15 | ±0.2 | ±0.3 | ±0.5
中等级m | ±0.1 | ±0.1 | ±0.2 | ±0.3 | ±0.4 | ±0.5 | ±0.8
粗糙级c | ±0.15 | ±0.2 | ±0.3 | ±0.5 | ±0.8 | ±1.2 | ±3.0

1.所有材料及加工工艺符合“RoHS”要求；
2.产品要求无断路、破损、露铜、压伤等不良；
3.带*号的尺寸为重点尺寸，带()尺寸为参考尺寸；
4.耐温范围-70℃-500℃，温度系数TCR-3850ppm/k;
5.引线端拉力应≥20N不脱落；
6.绝缘阻抗要求20℃时>100MΩ，500℃时>2MΩ；
7.未注尺寸公差按±5mm管控；

7 | 1.25-2P
6 | 28AWG，白色 | 2
5 | ∅2.5mm高温热缩套管(长度10mm） | 1
4 | ∅1mm高温棕色聚酰亚胺管(长度要求20mm) | 2
3 | ∅0.4*0.06mm棕色聚酰亚胺管 | 2
2 | ∅0.2±0.02mm镀镍线 | 2
1 | PT1000 B级电阻温度传感器 | 1
序号 | 规格参数 | 用量

线性公差按GB/T1804-m级执行；形位公差按GB/T1184-K级执行 | 设 计 | RenSX | 2025/2/12 | 捷鑫华科技有限公司 | 材料
审 核 | 共1张 | 第1张 | | 机型 | MP4602

3 | A1.2 | 调整传感器高温套管材质 | RenSX | 2025-3-3 | 线性基本尺 寸分段的极 偏差数值
2 | A1.1 | 增加了传感器高温套管公差 | RenSX | 2025-2-12 | | ±0.2 | ＞30~120 ±0.3 | ＞120~400 ±0.5 | ＞400~1000 ±0.8 | ＞1000~2000 ±1.2 | ＞2000~4000 ±2.0 ＞6～30

批 准 | | | 阶 段 标 记 | 数 量 | 重 量 | 比 例 | 图号 | JXHMP4602-08052-f

1 | A1、A2、B1 | XXXXXXXXXXXXXX | XXX | XXXX/XX/XX | 直线度和平 公差值 面度的未注 | ≤10 | ＞10~30 0.1 | ＞30~100 0.2 | ＞100~300 0.4 | ＞300~1000 0.6 | ＞1000~3000 0.05 0.8
A0 | | | 1 | X | 1：1 | 名称 | 温度传感器

序号 | 修订区域 | 修订内容 | 修订人 | 修订日期
