Sovol3d/SOVOL-ZERO/PDF/热床/JXHMP4602-02008-f 热床板.pdf

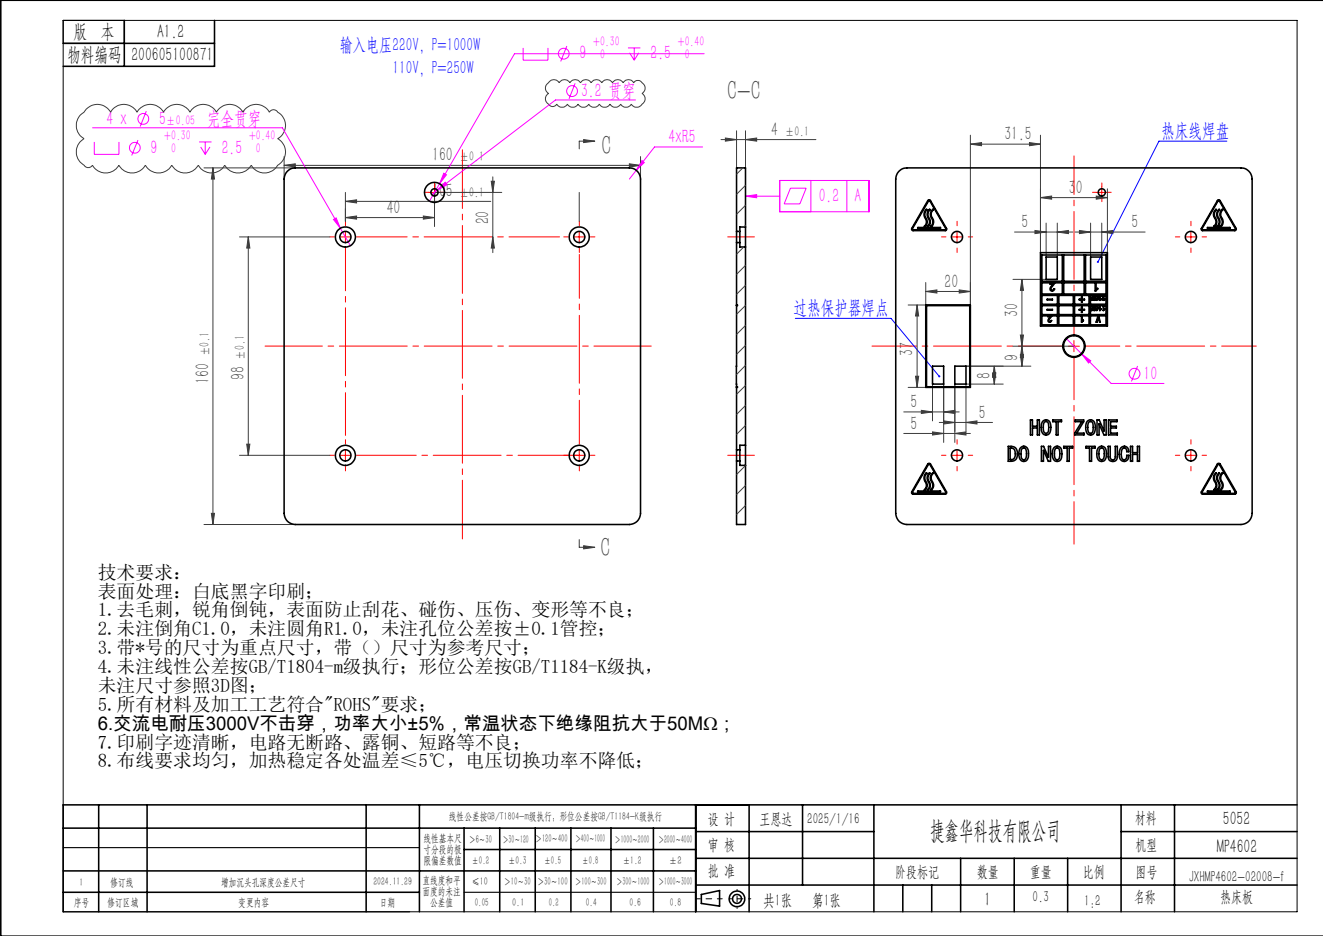
[picture p107: page 1]
5±0.05 完全贯穿; 王恩达 2025/1/16

技术要求：
表面处理：白底黑字印刷；
1.去毛刺，锐角倒钝，表面防止刮花、碰伤、压伤、变形等不良；
2.未注倒角C1.0，未注圆角R1.0，未注孔位公差按±0.1管控；
3.带*号的尺寸为重点尺寸，带（）尺寸为参考尺寸；
4.未注线性公差按GB/T1804-m级执行；形位公差按GB/T1184-K级执，
未注尺寸参照3D图；
5.所有材料及加工工艺符合"ROHS"要求；
6.交流电耐压3000V不击穿，功率大小±5%，常温状态下绝缘阻抗大于50MΩ；
7.印刷字迹清晰，电路无断路、露铜、短路等不良；
8.布线要求均匀，加热稳定各处温差≤5℃，电压切换功率不降低；

线性公差按GB/T1804-m级执行；形位公差按GB/T1184-K级执行
