Sovol3d/SOVOL-ZERO/PDF/热敏/JXHMP4602-08052-f 温度传感器 PT1000B-模型.pdf

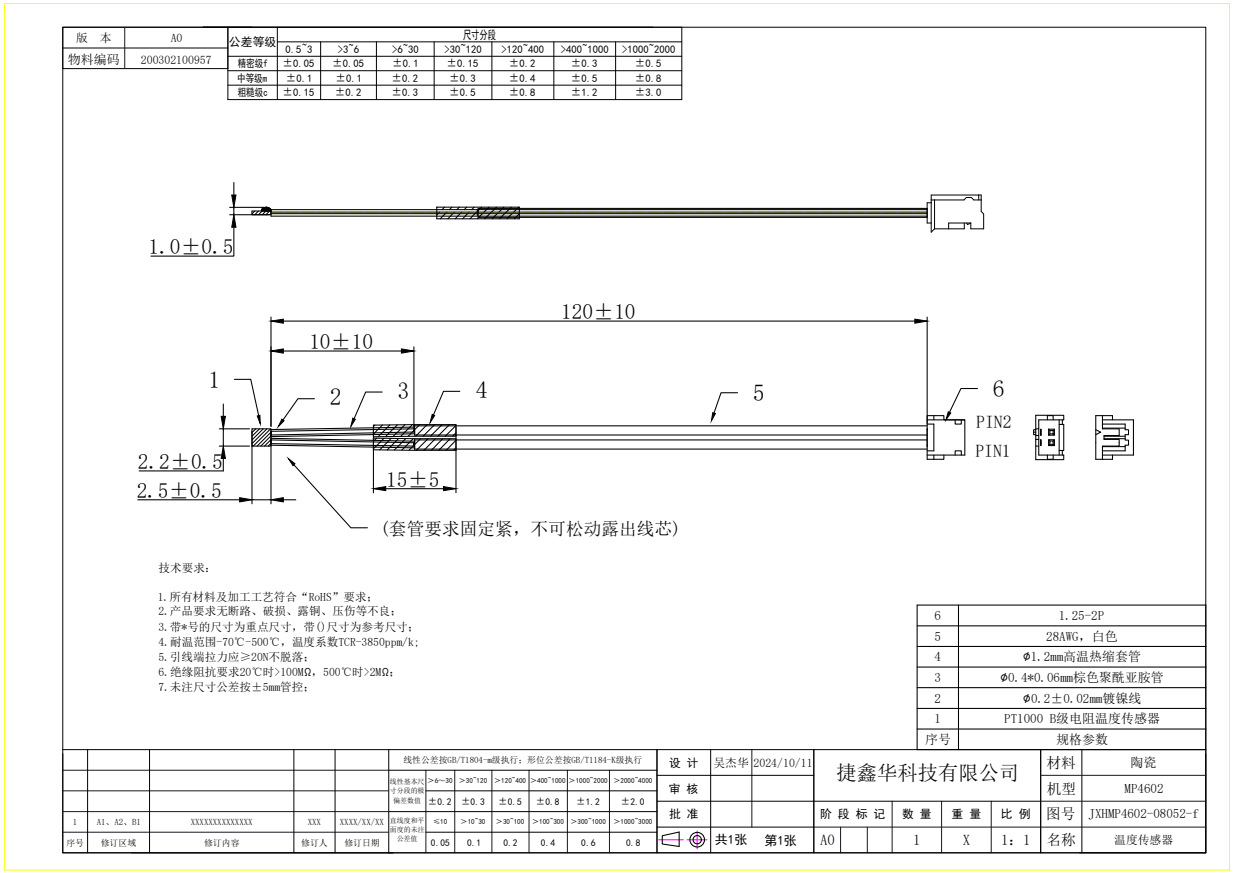
[picture p108: page 1]

版 本 | A0 | 公差等级 | 尺寸分段

物料编码 | 200302100957

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

6 | 1.25-2P
5 | 28AWG，白色
4 | ∅1.2mm高温热缩套管
3 | ∅0.4*0.06mm棕色聚酰亚胺管
2 | ∅0.2±0.02mm镀镍线
1 | PT1000 B级电阻温度传感器
序号 | 规格参数

线性公差按GB/T1804-m级执行；形位公差按GB/T1184-K级执行 | 设 计 | 吴杰华 | 2024/10/11 | 捷鑫华科技有限公司 | 材料
审 核 | 共1张 | 第1张 | | 机型 | MP4602

线性基本尺 寸分段的极 偏差数值

批 准 | | 阶 段 标 记 | 数 量 | 重 量 | 比 例 | 图号 | JXHMP4602-08052-f

1 | A1、A2、B1 | XXXXXXXXXXXXXX | XXX | XXXX/XX/XX | 直线度和平 公差值 面度的未注 | ≤10 | ＞10~30 0.1 | ＞30~100 0.2 | ＞100~300 0.4 | ＞300~1000 0.6 | ＞1000~3000 0.05 0.8
序号 | 修订区域 | 修订内容 | 修订人 | 修订日期

A0 | | | 1 | X | 1：1 | 名称 | 温度传感器
