Sovol3d/SOVOL-ZERO/sovol/patch/config/get_ip.cfg

[gcode_shell_command get_ip]
command: /home/sovol/get_ip.sh
timeout: 2.
verbose: True
[gcode_macro _GET_IP]
gcode:
    RUN_SHELL_COMMAND CMD=get_ip

[gcode_shell_command ota]
command: /home/sovol/ota_client.sh
timeout: 6.
verbose: True
[gcode_macro _OTA]
gcode:
    RUN_SHELL_COMMAND CMD=ota

[gcode_shell_command extruder_mcu_up]
command: /home/sovol/printer_data/build/extruder_mcu_update_fw.sh
timeout: 30.
verbose: True
[gcode_macro _EXTRUDER_MCU_UP]
gcode:
    RUN_SHELL_COMMAND CMD=extruder_mcu_up
    
[gcode_shell_command extra_mcu_up]
command: /home/sovol/printer_data/build/extra_mcu_update_fw.sh
timeout: 30.
verbose: True
[gcode_macro _EXTRA_MCU_UP]
gcode:
    RUN_SHELL_COMMAND CMD=extra_mcu_up

[gcode_shell_command mcu_up]
command: /home/sovol/printer_data/build/mcu_update_fw.sh
timeout: 30.
verbose: True
[gcode_macro _MCU_UP]
gcode:
    RUN_SHELL_COMMAND CMD=mcu_up

[gcode_shell_command obico_restart]
command: systemctl restart moonraker-obico.service
timeout: 2.
verbose: True
[gcode_macro _OBICO_RESTART]
gcode:
    RUN_SHELL_COMMAND CMD=obico_restart

[gcode_macro _OBICO_CODE_GET]
gcode:
    _OBICO_RESTART
    M117 Code Getting
    UPDATE_DELAYED_GCODE ID=code_display DURATION=4
    
[delayed_gcode code_display]
gcode:
    OBICO_LINK_STATUS
