Sovol3d/SOVOL-ZERO/sovol/patch/config/shell_command.cfg

[gcode_shell_command hello_world]
command: echo hello world
timeout: 2.
verbose: True
[gcode_macro HELLO_WORLD]
gcode:
    RUN_SHELL_COMMAND CMD=hello_world
